night-ghost/open-headtracker/(list of files, drawings)

Other design files:
board/DIY headtracker layout.lay
board/DIY headtracker layout.lay6
