night-ghost/open-headtracker/Source Code/DIY_Headtracker_Firmware_orig/DIY_headtracker/DIY_headtracker.ino

//-----------------------------------------------------------------------------
// Original project by Dennis Frie - 2012 - Dennis.frie@gmail.com
// Discussion: http://www.rcgroups.com/forums/showthread.php?t=1677559
//
// Other contributors to this code:
//  Mark Mansur (Mangus on rcgroups)
//  
// Version history:
// - 0.01 - 0.08 - Dennis Frie - preliminary releases
// - 1.01 - April 2013 - Mark Mansur - code clean-up and refactoring, comments
//      added. Added pause functionality, added settings retrieval commands.
//      Minor optimizations.
//-----------------------------------------------------------------------------

#include <Wire.h>
#include "config.h"
#include "functions.h"
#include "sensors.h"
#include <EEPROM.h>

#include <SingleSerial.h>
SingleSerialPort(Serial);
/*
Channel mapping/config for PPM out:

1 = PPM CHANNEL 1
2 = PPM CHANNEL 2
3 = PPM CHANNEL 3
4 = PPM CHANNEL 4
5 = PPM CHANNEL 5
6 = PPM CHANNEL 6
7 = PPM CHANNEL 7
8 = PPM CHANNEL 8
9 = PPM CHANNEL 9
10 = PPM CHANNEL 10
11 = PPM CHANNEL 11
12 = PPM CHANNEL 12

Mapping example:
$123456789111CH
*/


// Local file variables
//
int frameNumber = 0;		    // Frame count since last debug serial output

char serial_data[101];          // Array for serial-data 
byte serial_index = 0; // How many bytes have been received?
char string_started = 0;        // Only saves data if string starts with right byte
byte channel_mapping[14];

char outputMag = 0;             // Stream magnetometer data to host
char outputAcc = 0;             // Stream accelerometer data to host
char outputMagAcc = 0;          // Stream mag and accell data (for calibration on PC)
char outputTrack = 0;	        // Stream angle data to host

// Keep track of button press
char lastButtonState = 0;           // 0 is not pressed, 1 is pressed
unsigned long buttonDownTime = 0;   // the system time of the press
char pauseToggled = 0;              // Used to make sure we toggle pause only once per hold
char ht_paused = 0;

// External variables (defined in other files)
//
extern unsigned char PpmIn_PpmOut[13];
extern char read_sensors;
extern char resetValues;   
extern char tiltInverse;
extern char rollInverse;
extern char panInverse;

// Settings (Defined in sensors.cpp)
//
extern float tiltRollBeta;
extern float panBeta;
extern float gyroWeightTiltRoll;
extern float GyroWeightPan;
extern int servoPanCenter;
extern int servoTiltCenter;
extern int servoRollCenter;
extern int panMaxPulse;
extern int panMinPulse;
extern int tiltMaxPulse;
extern int tiltMinPulse;
extern int rollMaxPulse;
extern int rollMinPulse;
extern float panFactor;
extern float tiltFactor;  
extern float rollFactor;
extern unsigned char servoReverseMask;
extern unsigned char htChannels[];
extern float gyroOff[];
extern float magOffset[];
extern int accOffset[]; 
// End settings   

//--------------------------------------------------------------------------------------
// Func: setup
// Desc: Called by Arduino framework at initialization time. This sets up pins for I/O,
//       initializes sensors, etc.
//--------------------------------------------------------------------------------------
void setup()
{
    Serial.begin(SERIAL_BAUD);

  
    pinMode(9,OUTPUT);
    digitalWrite(2,HIGH);
    digitalWrite(3,HIGH);  
  
    // Set all other pins to input, for safety.
    pinMode(0,INPUT);
    pinMode(1,INPUT);
    pinMode(2,INPUT);
    pinMode(3,INPUT);
    pinMode(6,INPUT);
    pinMode(7,INPUT);  
    pinMode(8,INPUT);    

    // Set button pin to input:
    pinMode(BUTTON_INPUT,INPUT);
  
    // Set internal pull-up resistor. 
    digitalWrite(BUTTON_INPUT,HIGH);
  
    digitalWrite(0,LOW); // pull-down resistor
    digitalWrite(1,LOW);
    digitalWrite(2,HIGH);
    digitalWrite(3,HIGH);  
  
    pinMode(ARDUINO_LED,OUTPUT);    // Arduino LED
    digitalWrite(ARDUINO_LED, HIGH);
    
#if FATSHARK_HT_MODULE
    pinMode(BUZZER,OUTPUT);         // Buzzer
    digitalWrite(BUZZER, HIGH);
#endif

    // Give it time to be noticed, then turn it off
    delay(200); // Note: only use delay here. This won't work when Timer0 is repurposed later.
    digitalWrite(ARDUINO_LED, LOW);

#if FATSHARK_HT_MODULE
    digitalWrite(BUZZER, LOW);
#endif

    InitPWMInterrupt();         // Start PWM interrupt  
    Wire.begin();               // Start I2C

    // If the device have just been programmed, write initial config/values to EEPROM:
    if (EEPROM.read(0) != 8)
    {
//#if (DEBUG)
        Serial.println("New board - saving default values!");
//#endif    
    
        InitSensors();
#if (ALWAYS_CAL_GYRO)    
        SetGyroOffset();
#endif     

        SaveSettings();
        SaveMagData();
        SaveAccelData();
    }
 
    GetSettings();                 // Get settings saved in EEPROM
    InitSensors();                // Initialize I2C sensors
    CalibrateMag();
    ResetCenter();
    InitTimerInterrupt();        // Start timer interrupt (for sensors)  
}

//--------------------------------------------------------------------------------------
// Func: loop
// Desc: Called by the Arduino framework once per frame. Represents main program loop.
//--------------------------------------------------------------------------------------
void loop()
{  
    // Check input button for reset/pause request
    char buttonPressed = (digitalRead(BUTTON_INPUT) == 0);

    if ( buttonPressed && lastButtonState == 0)
    {
        resetValues = 1; 
        buttonDownTime = 0;
        lastButtonState = 1;
    }
    
    if ( buttonPressed )
    {
        if ( !pauseToggled && (buttonDownTime > BUTTON_HOLD_PAUSE_THRESH) )
        {
            // Pause/unpause
            ht_paused = !ht_paused;
            resetValues = 1;
            pauseToggled = 1;
        }
    }
    else
    {
        pauseToggled = 0;
        lastButtonState = 0;
    }
    
    // All this is used for communication with GUI 
    //
    if (Serial.available())
    {
        if (string_started == 1)
        {
            // Read incoming byte
            serial_data[serial_index++] = Serial.read();
           
            // If string ends with "CH" it's channel configuration, that have been received.
            // String must always be 12 chars/bytes and ending with CH to be valid. 
            if (serial_index == 14 &&
                serial_data[serial_index-2] == 'C' &&
                serial_data[serial_index-1] == 'H' )
            {
                // To keep it simple, we will not let the channels be 0-initialized, but
                // start from 1 to match actual channels. 
                for (unsigned char i = 0; i < 13; i++)  {
                    channel_mapping[i + 1] = serial_data[i] - 48;
                  
                    // Update the dedicated PPM-in -> PPM-out array for faster performance.
                    if ((serial_data[i] - 48) < 14) {
                        PpmIn_PpmOut[serial_data[i]-48] = i + 1;
                    }
                }
               
                Serial.println("Channel mapping received");
               
               // Reset serial_index and serial_started
               serial_index = 0;
               string_started = 0;
            }
            
            // Configure headtracker
            else if (serial_data[serial_index-2] == 'H' &&
                     serial_data[serial_index-1] == 'E')
            {
                // HT parameters are passed in from the PC in this order:
                //
                // 0 tiltRollBeta      
                // 1 panBeta       
                // 2 gyroWeightTiltRoll    
                // 3 GyroWeightPan 
                // 4 tiltFactor        
                // 5 panFactor          
                // 6 rollFactor
                // 7 servoReverseMask
                // 8 servoPanCenter
                // 9 panMinPulse 
                // 10 panMaxPulse
                // 11 servoTiltCenter
                // 12 tiltMinPulse
                // 13 tiltMaxPulse
                // 14 servoRollCenter
                // 15 rollMinPulse
                // 16 rollMaxPulse
                // 17 htChannels[0]  // pan            
                // 18 htChannels[1]  // tilt 
                // 19 htChannels[2]  // roll         
             
                // Parameters from the PC client need to be scaled to match our local
                // expectations

                Serial.println("HT config received:");
           
                int valuesReceived[20] = {0,0,0,0,0,0,0,0,0,0,0,0,0,0,0,0,0,0,0,0};
                int comma_index = 0;

                for (unsigned char k = 0; k < serial_index - 2; k++)
                {
                    // Looking for comma
                    if (serial_data[k] == 44)
                    {
                        comma_index++;
                    }
                    else
                    {
                        valuesReceived[comma_index] = valuesReceived[comma_index] * 10 + (serial_data[k] - 48);
                    }
             
#if (DEBUG)
                    Serial.print(serial_data[k]);
#endif
                }

#if (DEBUG)
                Serial.println();
                for (unsigned char k = 0; k < comma_index+1; k++)
                {
                    Serial.print(valuesReceived[k]); 
                    Serial.print(",");           
                }
                Serial.println();
#endif

                tiltRollBeta  = (float)valuesReceived[0] / 100;  
                panBeta       = (float)valuesReceived[1] / 100;
                gyroWeightTiltRoll = (float)valuesReceived[2] / 100;
                GyroWeightPan = (float)valuesReceived[3] / 100;
                tiltFactor    = (float)valuesReceived[4] / 10;         
                panFactor     = (float)valuesReceived[5] / 10;          
                rollFactor    = (float)valuesReceived[6] / 10;   

                servoReverseMask = (unsigned char)valuesReceived[7];

                tiltInverse = 1;
                rollInverse = 1;
                panInverse = 1;           
                
                if ((servoReverseMask & HT_PAN_REVERSE_BIT) != 0)
                {
                    panInverse = -1;
                }
                if ((servoReverseMask & HT_ROLL_REVERSE_BIT) != 0)
                {
                    rollInverse = -1; 
                }
                if ((servoReverseMask & HT_TILT_REVERSE_BIT) != 0)
                {
                    tiltInverse = -1;
                }

                servoPanCenter = valuesReceived[8];
                panMinPulse = valuesReceived[9];
                panMaxPulse = valuesReceived[10];         
         
                servoTiltCenter = valuesReceived[11];
                tiltMinPulse = valuesReceived[12];
                tiltMaxPulse = valuesReceived[13];         

                servoRollCenter = valuesReceived[14];
                rollMinPulse = valuesReceived[15];
                rollMaxPulse = valuesReceived[16];              
     
                htChannels[0] = valuesReceived[17];                   
                htChannels[1] = valuesReceived[18];              
                htChannels[2] = valuesReceived[19];                       

                Serial.println(htChannels[0]);
                Serial.println(htChannels[1]);
                Serial.println(htChannels[2]);                
        
                SaveSettings();

                serial_index = 0;
                string_started = 0;
            } // end configure headtracker
          
            // Debug info
            else if (serial_data[serial_index-5] == 'D' &&
                     serial_data[serial_index-4] == 'E' &&
                     serial_data[serial_index-3] == 'B' &&
                     serial_data[serial_index-2] == 'U' &&
                     serial_data[serial_index-1] == 'G')
            {  
                DebugOutput();
                serial_index = 0;
                string_started = 0; 
            }

            // Firmware version requested
            else if (serial_data[serial_index-4] == 'V' &&
                     serial_data[serial_index-3] == 'E' &&
                     serial_data[serial_index-2] == 'R' &&
                     serial_data[serial_index-1] == 'S')
            {
                Serial.print("FW: ");
                Serial.println(FIRMWARE_VERSION_FLOAT, 2);
                serial_index = 0;
                string_started = 0; 
            }
          
            // Start mag and accel data stream
            else if (serial_data[serial_index-4] == 'C' &&
                     serial_data[serial_index-3] == 'M' &&
                     serial_data[serial_index-2] == 'A' &&
                     serial_data[serial_index-1] == 'S')
            {  
                outputMagAcc = 1;
                outputMag = 0;
                outputAcc = 0;
                outputTrack = 0;
                serial_index = 0;
                string_started = 0;
            }        

            // Stop mag and accel data stream
            else if (serial_data[serial_index-4] == 'C' &&
                     serial_data[serial_index-3] == 'M' &&
                     serial_data[serial_index-2] == 'A' &&
                     serial_data[serial_index-1] == 'E')
            {  
                outputMagAcc = 0;
                outputMag = 0;
                outputTrack = 0;
                outputAcc = 0;
                serial_index = 0;
                string_started = 0;
            }        

            // Start magnetometer data stream
            else if (serial_data[serial_index-4] == 'C' &&
                     serial_data[serial_index-3] == 'A' &&
                     serial_data[serial_index-2] == 'S' &&
                     serial_data[serial_index-1] == 'T')
            {  
                outputMag = 1;
                outputMagAcc = 0;
                outputAcc = 0;
                outputTrack = 0;
                serial_index = 0;
                string_started = 0; 

            }        
          
            // Stop magnetometer data stream
            else if (serial_data[serial_index-4] == 'C' &&
                     serial_data[serial_index-3] == 'A' &&
                     serial_data[serial_index-2] == 'E' &&
                     serial_data[serial_index-1] == 'N')
            {  
                outputMag = 0;
                outputMagAcc = 0;
                outputAcc = 0;
                outputTrack = 0;
                serial_index = 0;
                string_started = 0; 
            }

            // Start accelerometer data stream
            else if (serial_data[serial_index-4] == 'G' &&
                     serial_data[serial_index-3] == 'R' &&
                     serial_data[serial_index-2] == 'A' &&
                     serial_data[serial_index-1] == 'V')
            {  
                outputAcc = 1;     
                outputMagAcc = 0;
                outputMag = 0;
                outputTrack = 0;
                serial_index = 0;
                string_started = 0; 
            }              
          
            // Stop accelerometer data stream
            else if (serial_data[serial_index-4] == 'G' &&
                     serial_data[serial_index-3] == 'R' &&
                     serial_data[serial_index-2] == 'E' &&
                     serial_data[serial_index-1] == 'N')
            {  
                outputAcc = 0;
                outputMag = 0;
                outputMagAcc = 0;
                outputTrack = 0;
                serial_index = 0;
                string_started = 0; 
            }

            // Start tracking data stream
            else if (serial_data[serial_index-4] == 'P' &&
                     serial_data[serial_index-3] == 'L' &&
                     serial_data[serial_index-2] == 'S' &&
                     serial_data[serial_index-1] == 'T')
            {  
                outputTrack = 1;
                outputMagAcc = 0;
                outputMag = 0;
                outputAcc = 0;
                serial_index = 0;
                string_started = 0; 
            }        

            // Stop tracking data stream          
            else if (serial_data[serial_index-4] == 'P' &&
                     serial_data[serial_index-3] == 'L' &&
                     serial_data[serial_index-2] == 'E' &&
                     serial_data[serial_index-1] == 'N')
            {  
                outputTrack = 0;
                outputMag = 0;
                outputAcc = 0;
                outputMagAcc = 0;
                serial_index = 0;
                string_started = 0; 
            }
          
            // Save RAM settings to EEPROM
            else if (serial_data[serial_index-4] == 'S' &&
                     serial_data[serial_index-3] == 'A' &&
                     serial_data[serial_index-2] == 'V' &&
                     serial_data[serial_index-1] == 'E')
            {  
                SaveSettings();     
                serial_index = 0;
                string_started = 0; 
            }          
          
            // Calibrate gyro
            else if (serial_data[serial_index-4] == 'C' &&
                     serial_data[serial_index-3] == 'A' &&
                     serial_data[serial_index-2] == 'L' &&
                     serial_data[serial_index-1] == 'G')
            { 
                SetGyroOffset();
                SaveSettings();
               
                Serial.print("Gyro offset measured:");
                Serial.print(gyroOff[0]);
                Serial.print(",");   
                Serial.print(gyroOff[1]);
                Serial.print(",");      
                Serial.println(gyroOff[2]);    
               
                serial_index = 0;
                string_started = 0; 
            }

            // Store magnetometer offset
            else if (serial_data[serial_index-3] == 'M' &&
                     serial_data[serial_index-2] == 'A' &&
                     serial_data[serial_index-1] == 'G')
            {
                Serial.println(serial_data);
                int valuesReceived[5] = {0,0,0,0,0};
                int comma_index = 0; 
              
                for (unsigned char k = 0; k < serial_index - 3; k++)
                {
                    // Looking for comma
                    if (serial_data[k] == 44)
                    {
                        comma_index++;
                    }
                    else
                    {
                        valuesReceived[comma_index] = valuesReceived[comma_index] * 10 + (serial_data[k] - 48);
                    }
                }
                
                // Y and Z are swapped on purpose.
                magOffset[0] = valuesReceived[0] - 2000;
                magOffset[1] = valuesReceived[2] - 2000;
                magOffset[2] = valuesReceived[1] - 2000;

                serial_index = 0;
                string_started = 0; 

                SaveMagData();                
            }

            // Store accelerometer offset
            else if (serial_data[serial_index-3] == 'A' &&
                     serial_data[serial_index-2] == 'C' &&
                     serial_data[serial_index-1] == 'C')
            {
                Serial.println(serial_data);
                int valuesReceived[5] = {0,0,0,0,0};
                int comma_index = 0; 
                for (unsigned char k = 0; k < serial_index - 3; k++)
                {
                    // Looking for comma
                    if (serial_data[k] == 44)
                    {
                        comma_index++;
                    }
                    else
                    {
                        valuesReceived[comma_index] = valuesReceived[comma_index] * 10 + (serial_data[k] - 48);
                    }              
                }

                accOffset[0] = valuesReceived[0] - 2000;
                accOffset[1] = valuesReceived[1] - 2000;
                accOffset[2] = valuesReceived[2] - 2000;
                
                serial_index = 0;
                string_started = 0; 

                SaveAccelData();                
            }

            // Retrieve settings
            else if (serial_data[serial_index-4] == 'G' &&
                     serial_data[serial_index-3] == 'S' &&
                     serial_data[serial_index-2] == 'E' &&
                     serial_data[serial_index-1] == 'T' )
            {
                // Get Settings. Scale our local values to
                // real-world values usable on the PC side.
                //
                Serial.print("$SET$"); // something recognizable in the stream

                Serial.print(tiltRollBeta * 100);
                Serial.print(",");   
                Serial.print(panBeta * 100);
                Serial.print(",");
                Serial.print(gyroWeightTiltRoll * 100);  
                Serial.print(",");
                Serial.print(GyroWeightPan * 100);
                Serial.print(",");
                Serial.print(tiltFactor * 10);
                Serial.print(",");
                Serial.print(panFactor * 10);
                Serial.print(",");
                Serial.print(rollFactor * 10);
                Serial.print(",");
                Serial.print(servoReverseMask);
                Serial.print(",");
                Serial.print(servoPanCenter);
                Serial.print(",");
                Serial.print(panMinPulse);
                Serial.print(",");
                Serial.print(panMaxPulse);
                Serial.print(",");
                Serial.print(servoTiltCenter);
                Serial.print(",");
                Serial.print(tiltMinPulse);
                Serial.print(",");
                Serial.print(tiltMaxPulse);
                Serial.print(",");
                Serial.print(servoRollCenter);
                Serial.print(",");
                Serial.print(rollMinPulse);
                Serial.print(",");
                Serial.print(rollMaxPulse);
                Serial.print(",");
                Serial.print(htChannels[0]);
                Serial.print(",");
                Serial.print(htChannels[1]);
                Serial.print(",");
                Serial.println(htChannels[2]);

                Serial.println("Settings Retrieved!");

                serial_index = 0;
                string_started = 0;
            }
            else if (serial_index > 100)
            {
                // If more than 100 bytes have been received, the string is not valid.
                // Reset and "try again" (wait for $ to indicate start of new string). 
                serial_index = 0;
                string_started = 0;
            }
        }
        else if (Serial.read() == '$')
        {
            string_started = 1;
        }
    } // serial port input

    // if "read_sensors" flag is set high, read sensors and update
    if (read_sensors == 1 && ht_paused == 0)
    {
        UpdateSensors();
        GyroCalc();
        AccelCalc();
        MagCalc();
        FilterSensorData();    
               
        // Only output this data every X frames.
        if (frameNumber++ >= SERIAL_OUTPUT_FRAME_INTERVAL)
        {
            if (outputTrack == 1)
            {
                trackerOutput();
            }
            else if (outputMagAcc == 1)
            {
                calMagAccOutput();
            }
            else if (outputMag == 1)
            {
                calMagOutput(); 
            }
            else if (outputAcc == 1)
            {
                calAccOutput();
            }
            frameNumber = 0; 
        }

        // Will first update read_sensors when everything is done.  
        read_sensors = 0;
    }
}

//--------------------------------------------------------------------------------------
// Func: SaveSettings
// Desc: Saves device settings to EEPROM for retrieval at boot-up.
//--------------------------------------------------------------------------------------
void SaveSettings()
{  
    EEPROM.write(1, (unsigned char)(tiltRollBeta * 100));
    EEPROM.write(2, (unsigned char)(panBeta * 100));
    EEPROM.write(3, (unsigned char)(gyroWeightTiltRoll * 100));
    EEPROM.write(4, (unsigned char)(GyroWeightPan * 100));
  
    EEPROM.write(5, (unsigned char)servoReverseMask);
    
    // 6 unused
  
    EEPROM.write(7, (unsigned char)servoPanCenter);
    EEPROM.write(8, (unsigned char)(servoPanCenter >> 8));  
  
    EEPROM.write(9, (unsigned char)(tiltFactor * 10));
    EEPROM.write(10, (int)((tiltFactor * 10)) >> 8);  

    EEPROM.write(11, (unsigned char) (panFactor * 10));
    EEPROM.write(12, (int)((panFactor * 10)) >> 8);  

    EEPROM.write(13, (unsigned char) (rollFactor * 10));
    EEPROM.write(14, (int)((rollFactor * 10)) >> 8);  

    // 15 unused

    EEPROM.write(16, (unsigned char)servoTiltCenter);
    EEPROM.write(17, (unsigned char)(servoTiltCenter >> 8));  

    EEPROM.write(18, (unsigned char)servoRollCenter);
    EEPROM.write(19, (unsigned char)(servoRollCenter >> 8));  


    EEPROM.write(20, (unsigned char)panMaxPulse);
    EEPROM.write(21, (unsigned char)(panMaxPulse >> 8));  
  
    EEPROM.write(22, (unsigned char)panMinPulse);
    EEPROM.write(23, (unsigned char)(panMinPulse >> 8));    

    EEPROM.write(24, (unsigned char)tiltMaxPulse);
    EEPROM.write(25, (unsigned char)(tiltMaxPulse >> 8));    

    EEPROM.write(26, (unsigned char)tiltMinPulse);
    EEPROM.write(27, (unsigned char)(tiltMinPulse >> 8));

    EEPROM.write(28, (unsigned char)rollMaxPulse);
    EEPROM.write(29, (unsigned char)(rollMaxPulse >> 8));    

    EEPROM.write(30, (unsigned char)rollMinPulse);
    EEPROM.write(31, (unsigned char)(rollMinPulse >> 8)); 
  
    EEPROM.write(32, (unsigned char)htChannels[0]);
    EEPROM.write(33, (unsigned char)htChannels[1]);
    EEPROM.write(34, (unsigned char)htChannels[2]);
  
    // Saving gyro calibration values
    int temp = (int)(gyroOff[0] + 500.5);
    EEPROM.write(35, (unsigned char)temp);
    EEPROM.write(36, (unsigned char)(temp >> 8));   
  
    temp = (int)(gyroOff[1] + 500.5);
    EEPROM.write(37, (unsigned char)temp);
    EEPROM.write(38, (unsigned char)(temp >> 8));     

    temp = (int)(gyroOff[2] + 500.5);
    EEPROM.write(39, (unsigned char)temp);
    EEPROM.write(40, (unsigned char)(temp >> 8));    
  
    // Mark the memory to indicate that it has been
    // written. Used to determine if board is newly flashed
    // or not.
    EEPROM.write(0,8); 

    Serial.println("Settings saved!");
}

//--------------------------------------------------------------------------------------
// Func: GetSettings
// Desc: Retrieves device settings from EEPROM.
//--------------------------------------------------------------------------------------
void GetSettings()
{  
    tiltRollBeta    = (float)EEPROM.read(1) / 100;
    panBeta         = (float)EEPROM.read(2) / 100;
    gyroWeightTiltRoll = (float)EEPROM.read(3) / 100;
    GyroWeightPan   = (float)EEPROM.read(4) / 100;  
  
    tiltInverse = 1;
    rollInverse = 1;
    panInverse = 1;

    unsigned char temp = EEPROM.read(5);
    if ( temp & HT_TILT_REVERSE_BIT )
    {
        tiltInverse = -1;
    }  
    if ( temp & HT_ROLL_REVERSE_BIT )
    {
        rollInverse = -1;
    }
    if ( temp & HT_PAN_REVERSE_BIT )
    {
        panInverse = -1;
    }

    // 6 unused

    servoPanCenter  = EEPROM.read(7) + (EEPROM.read(8) << 8);
    tiltFactor      = (float)(EEPROM.read(9) + (EEPROM.read(10) << 8)) / 10;
    panFactor       = (float)(EEPROM.read(11) + (EEPROM.read(12) << 8)) / 10;
    rollFactor       = (float)(EEPROM.read(13) + (EEPROM.read(14) << 8)) / 10;  

    // 15 unused

    servoTiltCenter = EEPROM.read(16) + (EEPROM.read(17) << 8);
    servoRollCenter = EEPROM.read(18) + (EEPROM.read(19) << 8);  
  
    panMaxPulse   = EEPROM.read(20) + (EEPROM.read(21) << 8);  
    panMinPulse   = EEPROM.read(22) + (EEPROM.read(23) << 8);    
  
    tiltMaxPulse  = EEPROM.read(24) + (EEPROM.read(25) << 8);  
    tiltMinPulse  = EEPROM.read(26) + (EEPROM.read(27) << 8);      
  
    rollMaxPulse  = EEPROM.read(28) + (EEPROM.read(29) << 8);  
    rollMinPulse  = EEPROM.read(30) + (EEPROM.read(31) << 8);        
  
    htChannels[0] = EEPROM.read(32);  
    htChannels[1] = EEPROM.read(33);  
    htChannels[2] = EEPROM.read(34);    
  
    gyroOff[0] = EEPROM.read(35) + (EEPROM.read(36) << 8) - 500; 
    gyroOff[1] = EEPROM.read(37) + (EEPROM.read(38) << 8) - 500; 
    gyroOff[2] = EEPROM.read(39) + (EEPROM.read(40) << 8) - 500;   
  
    magOffset[0] = EEPROM.read(200) + (EEPROM.read(201) << 8) - 2000;     
    magOffset[1] = EEPROM.read(202) + (EEPROM.read(203) << 8) - 2000;     
    magOffset[2] = EEPROM.read(204) + (EEPROM.read(205) << 8) - 2000;       
  
    accOffset[0] = EEPROM.read(206) + (EEPROM.read(207) << 8) - 2000;     
    accOffset[1] = EEPROM.read(208) + (EEPROM.read(209) << 8) - 2000;     
    accOffset[2] = EEPROM.read(210) + (EEPROM.read(211) << 8) - 2000;       
  
 
#if (DEBUG)
    DebugOutput();
#endif
}

//--------------------------------------------------------------------------------------
// Func: SaveMagData
// Desc: Stores magnetometer calibration info to EEPROM.
//--------------------------------------------------------------------------------------
void SaveMagData()
{
    int temp = (int)(magOffset[0] + 2000);
    EEPROM.write(200, (unsigned char)temp);
    EEPROM.write(201, (unsigned char)(temp >> 8));   
  
    temp = (int)(magOffset[1] + 2000);
    EEPROM.write(202, (unsigned char)temp);
    EEPROM.write(203, (unsigned char)(temp >> 8));   
  
    temp = (int)(magOffset[2] + 2000);
    EEPROM.write(204, (unsigned char)temp);
    EEPROM.write(205, (unsigned char)(temp >> 8));   
  
    Serial.println("Mag offset saved!"); 
    Serial.print(magOffset[0]);
    Serial.print(", "); 
    Serial.print(magOffset[1]);
    Serial.print(", ");   
    Serial.println(magOffset[2]); 
}

//--------------------------------------------------------------------------------------
// Func: SaveAccelData
// Desc: Stores accelerometer calibration data to EEPOM.
//--------------------------------------------------------------------------------------
void SaveAccelData()
{
    int temp = (int)(accOffset[0] + 2000);
    EEPROM.write(206, (unsigned char)temp);
    EEPROM.write(207, (unsigned char)(temp >> 8));   
  
    temp = (int)(accOffset[1] + 2000);
    EEPROM.write(208, (unsigned char)temp);
    EEPROM.write(209, (unsigned char)(temp >> 8));   
  
    temp = (int)(accOffset[2] + 2000);
    EEPROM.write(210, (unsigned char)temp);
    EEPROM.write(211, (unsigned char)(temp >> 8));   
  
    Serial.println("Acc offset saved!"); 
    Serial.print(accOffset[0]);
    Serial.print(","); 
    Serial.print(accOffset[1]);
    Serial.print(",");   
    Serial.println(accOffset[2]);  
}

//--------------------------------------------------------------------------------------
// Func: DebugOutput
// Desc: Outputs useful device/debug information to the serial port.
//--------------------------------------------------------------------------------------
void DebugOutput()
{
    Serial.println();  
    Serial.println();
    Serial.println();
    Serial.println("------ Debug info------");

    Serial.print("FW Version: ");
    Serial.println(FIRMWARE_VERSION_FLOAT, 2);
    
    Serial.print("tiltRollBeta: ");
    Serial.println(tiltRollBeta); 

    Serial.print("panBeta: ");
    Serial.println(panBeta); 
 
    Serial.print("gyroWeightTiltRoll: ");
    Serial.println(gyroWeightTiltRoll); 

    Serial.print("GyroWeightPan: ");
    Serial.println(GyroWeightPan); 

    Serial.print("servoPanCenter: ");
    Serial.println(servoPanCenter); 
 
    Serial.print("servoTiltCenter: ");
    Serial.println(servoTiltCenter); 

    Serial.print("servoRollCenter: ");
    Serial.println(servoRollCenter); 

    Serial.print("tiltFactor: ");
    Serial.println(tiltFactor); 

    Serial.print("panFactor: ");
    Serial.println(panFactor);  
 
    Serial.print("Gyro offset stored ");
    Serial.print(gyroOff[0]);
    Serial.print(",");   
    Serial.print(gyroOff[1]);
    Serial.print(",");      
    Serial.println(gyroOff[2]);    
 
    Serial.print("Mag offset stored ");
    Serial.print(magOffset[0]);
    Serial.print(",");   
    Serial.print(magOffset[1]);
    Serial.print(",");      
    Serial.println(magOffset[2]);
 
    Serial.print("Acc offset stored ");
    Serial.print(accOffset[0]);
    Serial.print(",");   
    Serial.print(accOffset[1]);
    Serial.print(",");      
    Serial.println(accOffset[2]);
 
    SensorInfoPrint();    
}
