night-ghost/open-headtracker/Source Code/DIY_headtracker_GY86/DIY_headtracker/mpu6050dmp6.cpp

/*
MPU6050 lib 0x02

copyright (c) Davide Gironi, 2012

Released under GPLv3.
Please refer to LICENSE file for licensing information.
*/

/*
 * This file contains all the functions needed to process 6-axis orientation by the internal chip processor
 */

//to enable get roll, pitch and yaw function we include the math function
//if some error appears we must add -lm and -lc to C linker, the linker line should become somethink like this
//${COMMAND} -lm ${FLAGS} ${OUTPUT_FLAG} ${OUTPUT_PREFIX}${OUTPUT} ${INPUTS} -lc


#include "mpu6050.h"

#if MPU6050_GETATTITUDE == 2

#include <avr/io.h>
#include <avr/pgmspace.h>
#include <avr/interrupt.h>
#include <util/delay.h>
#include <math.h>  //include libm

#define MPU6050_DMP_CODE_SIZE 1929
#define MPU6050_DMP_CONFIG_SIZE 192
#define MPU6050_DMP_UPDATES_SIZE 47

volatile uint8_t mpu6050_mpuInterrupt = 0;
uint8_t *dmpPacketBuffer;
uint16_t mpu6050_fifoCount = 0;
uint8_t mpu6050_mpuIntStatus = 0;
uint8_t mpu6050_fifoBuffer[64];


/* ================================================================================================ *
 | Default MotionApps v2.0 42-byte FIFO packet structure:                                           |
 |                                                                                                  |
 | [QUAT W][      ][QUAT X][      ][QUAT Y][      ][QUAT Z][      ][GYRO X][      ][GYRO Y][      ] |
 |   0   1   2   3   4   5   6   7   8   9  10  11  12  13  14  15  16  17  18  19  20  21  22  23  |
 |                                                                                                  |
 | [GYRO Z][      ][ACC X ][      ][ACC Y ][      ][ACC Z ][      ][      ]                         |
 |  24  25  26  27  28  29  30  31  32  33  34  35  36  37  38  39  40  41                          |
 * ================================================================================================ */

// this block of memory gets written to the MPU on start-up, and it seems
// to be volatile memory, so it has to be done each time (it only takes ~1
// second though)
const prog_uchar mpu6050_dmpMemory[MPU6050_DMP_CODE_SIZE] PROGMEM = {
    // bank 0, 256 bytes
    0xFB, 0x00, 0x00, 0x3E, 0x00, 0x0B, 0x00, 0x36, 0x00, 0x01, 0x00, 0x02, 0x00, 0x03, 0x00, 0x00,
    0x00, 0x65, 0x00, 0x54, 0xFF, 0xEF, 0x00, 0x00, 0xFA, 0x80, 0x00, 0x0B, 0x12, 0x82, 0x00, 0x01,
    0x00, 0x02, 0x00, 0x00, 0x00, 0x00, 0x00, 0x00, 0x00, 0x00, 0x00, 0x00, 0x00, 0x00, 0x00, 0x00,
    0x00, 0x28, 0x00, 0x00, 0xFF, 0xFF, 0x45, 0x81, 0xFF, 0xFF, 0xFA, 0x72, 0x00, 0x00, 0x00, 0x00,
    0x00, 0x00, 0x03, 0xE8, 0x00, 0x00, 0x00, 0x01, 0x00, 0x01, 0x7F, 0xFF, 0xFF, 0xFE, 0x80, 0x01,
    0x00, 0x1B, 0x00, 0x00, 0x00, 0x00, 0x00, 0x00, 0x00, 0x00, 0x00, 0x00, 0x00, 0x00, 0x00, 0x00,
    0x00, 0x3E, 0x03, 0x30, 0x40, 0x00, 0x00, 0x00, 0x02, 0xCA, 0xE3, 0x09, 0x3E, 0x80, 0x00, 0x00,
    0x20, 0x00, 0x00, 0x00, 0x00, 0x00, 0x00, 0x00, 0x40, 0x00, 0x00, 0x00, 0x60, 0x00, 0x00, 0x00,
    0x41, 0xFF, 0x00, 0x00, 0x00, 0x00, 0x0B, 0x2A, 0x00, 0x00, 0x16, 0x55, 0x00, 0x00, 0x21, 0x82,
    0xFD, 0x87, 0x26, 0x50, 0xFD, 0x80, 0x00, 0x00, 0x00, 0x1F, 0x00, 0x00, 0x00, 0x05, 0x80, 0x00,
    0x00, 0x00, 0x00, 0x00, 0x00, 0x01, 0x00, 0x00, 0x00, 0x02, 0x00, 0x00, 0x00, 0x03, 0x00, 0x00,
    0x40, 0x00, 0x00, 0x00, 0x00, 0x00, 0x04, 0x6F, 0x00, 0x02, 0x65, 0x32, 0x00, 0x00, 0x5E, 0xC0,
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
    0xA3, 0xB2, 0xA3, 0xA3, 0xA3, 0xA3, 0xA3, 0xA3, 0xB0, 0x87, 0xB5, 0x99, 0xF1, 0xA3, 0xA3, 0xA3,
    0x98, 0xF1, 0xA3, 0xA3, 0xA3, 0xA3, 0x97, 0xA3, 0xA3, 0xA3, 0xA3, 0xF3, 0x9B, 0xA3, 0xA3, 0xDC,
    0xB9, 0xA7, 0xF1, 0x26, 0x26, 0x26, 0xD8, 0xD8, 0xFF
};

const prog_uchar mpu6050_dmpConfig[MPU6050_DMP_CONFIG_SIZE] PROGMEM = {
//  BANK    OFFSET  LENGTH  [DATA]
    0x03,   0x7B,   0x03,   0x4C, 0xCD, 0x6C,         // FCFG_1 inv_set_gyro_calibration
    0x03,   0xAB,   0x03,   0x36, 0x56, 0x76,         // FCFG_3 inv_set_gyro_calibration
    0x00,   0x68,   0x04,   0x02, 0xCB, 0x47, 0xA2,   // D_0_104 inv_set_gyro_calibration
    0x02,   0x18,   0x04,   0x00, 0x05, 0x8B, 0xC1,   // D_0_24 inv_set_gyro_calibration
    0x01,   0x0C,   0x04,   0x00, 0x00, 0x00, 0x00,   // D_1_152 inv_set_accel_calibration
    0x03,   0x7F,   0x06,   0x0C, 0xC9, 0x2C, 0x97, 0x97, 0x97, // FCFG_2 inv_set_accel_calibration
    0x03,   0x89,   0x03,   0x26, 0x46, 0x66,         // FCFG_7 inv_set_accel_calibration
    0x00,   0x6C,   0x02,   0x20, 0x00,               // D_0_108 inv_set_accel_calibration
    0x02,   0x40,   0x04,   0x00, 0x00, 0x00, 0x00,   // CPASS_MTX_00 inv_set_compass_calibration
    0x02,   0x44,   0x04,   0x00, 0x00, 0x00, 0x00,   // CPASS_MTX_01
    0x02,   0x48,   0x04,   0x00, 0x00, 0x00, 0x00,   // CPASS_MTX_02
    0x02,   0x4C,   0x04,   0x00, 0x00, 0x00, 0x00,   // CPASS_MTX_10
    0x02,   0x50,   0x04,   0x00, 0x00, 0x00, 0x00,   // CPASS_MTX_11
    0x02,   0x54,   0x04,   0x00, 0x00, 0x00, 0x00,   // CPASS_MTX_12
    0x02,   0x58,   0x04,   0x00, 0x00, 0x00, 0x00,   // CPASS_MTX_20
    0x02,   0x5C,   0x04,   0x00, 0x00, 0x00, 0x00,   // CPASS_MTX_21
    0x02,   0xBC,   0x04,   0x00, 0x00, 0x00, 0x00,   // CPASS_MTX_22
    0x01,   0xEC,   0x04,   0x00, 0x00, 0x40, 0x00,   // D_1_236 inv_apply_endian_accel
    0x03,   0x7F,   0x06,   0x0C, 0xC9, 0x2C, 0x97, 0x97, 0x97, // FCFG_2 inv_set_mpu_sensors
    0x04,   0x02,   0x03,   0x0D, 0x35, 0x5D,         // CFG_MOTION_BIAS inv_turn_on_bias_from_no_motion
    0x04,   0x09,   0x04,   0x87, 0x2D, 0x35, 0x3D,   // FCFG_5 inv_set_bias_update
    0x00,   0xA3,   0x01,   0x00,                     // D_0_163 inv_set_dead_zone
                 // SPECIAL 0x01 = enable interrupts
    0x00,   0x00,   0x00,   0x01, // SET INT_ENABLE at i=22, SPECIAL INSTRUCTION
    0x07,   0x86,   0x01,   0xFE,                     // CFG_6 inv_set_fifo_interupt
    0x07,   0x41,   0x05,   0xF1, 0x20, 0x28, 0x30, 0x38, // CFG_8 inv_send_quaternion
    0x07,   0x7E,   0x01,   0x30,                     // CFG_16 inv_set_footer
    0x07,   0x46,   0x01,   0x9A,                     // CFG_GYRO_SOURCE inv_send_gyro
    0x07,   0x47,   0x04,   0xF1, 0x28, 0x30, 0x38,   // CFG_9 inv_send_gyro -> inv_construct3_fifo
    0x07,   0x6C,   0x04,   0xF1, 0x28, 0x30, 0x38,   // CFG_12 inv_send_accel -> inv_construct3_fifo
    0x02,   0x16,   0x02,   0x00, 0x09                // D_0_22 inv_set_fifo_rate

    // This very last 0x01 WAS a 0x09, which drops the FIFO rate down to 20 Hz. 0x07 is 25 Hz,
    // 0x01 is 100Hz. Going faster than 100Hz (0x00=200Hz) tends to result in very noisy data.
    // DMP output frequency is calculated easily using this equation: (200Hz / (1 + value))

    // It is important to make sure the host processor can keep up with reading and processing
    // the FIFO output at the desired rate. Handling FIFO overflow cleanly is also a good idea.
};

const prog_uchar mpu6050_dmpUpdates[MPU6050_DMP_UPDATES_SIZE] PROGMEM = {
    0x01,   0xB2,   0x02,   0xFF, 0xFF,
    0x01,   0x90,   0x04,   0x09, 0x23, 0xA1, 0x35,
    0x01,   0x6A,   0x02,   0x06, 0x00,
    0x01,   0x60,   0x08,   0x00, 0x00, 0x00, 0x00, 0x00, 0x00, 0x00, 0x00,
    0x00,   0x60,   0x04,   0x40, 0x00, 0x00, 0x00,
    0x01,   0x62,   0x02,   0x00, 0x00,
    0x00,   0x60,   0x04,   0x00, 0x40, 0x00, 0x00
};

/*
 * initialize mpu6050 dmp
 */
uint8_t mpu6050_dmpInitialize() {
	//setup interrupt
	MPU6050_DMP_INT0SETUP;

	//reset
	mpu6050_writeBit(MPU6050_RA_PWR_MGMT_1, MPU6050_PWR1_DEVICE_RESET_BIT, 1);
    _delay_ms(30);//wait after reset

    //disable sleep mode
    mpu6050_setSleepDisabled();

    //set memorybank to 0
    mpu6050_setMemoryBank(0, 0, 0);

    //get X/Y/Z gyro offsets
    int8_t xgOffset = mpu6050_getXGyroOffset();
    int8_t ygOffset = mpu6050_getYGyroOffset();
    int8_t zgOffset = mpu6050_getZGyroOffset();

    //setting slave 0 address to 0x7F
	mpu6050_writeByte(MPU6050_RA_I2C_SLV0_ADDR + 0*3, 0x7F);
	//disabling I2C Master mode
	mpu6050_writeBit(MPU6050_RA_USER_CTRL, MPU6050_USERCTRL_I2C_MST_EN_BIT, 0);
	//setting slave 0 address to 0x68 (self)
	mpu6050_writeByte(MPU6050_RA_I2C_SLV0_ADDR + 0*3, 0x68);
	//resetting I2C Master control
	mpu6050_writeBit(MPU6050_RA_USER_CTRL, MPU6050_USERCTRL_I2C_MST_RESET_BIT, 1);
	_delay_ms(20);

    //load DMP code into memory banks
    if (mpu6050_writeMemoryBlock(mpu6050_dmpMemory, MPU6050_DMP_CODE_SIZE, 0, 0, 1, 1) == 1) {
        if (mpu6050_writeDMPConfigurationSet(mpu6050_dmpConfig, MPU6050_DMP_CONFIG_SIZE, 1)) {

        	//set clock source
        	mpu6050_writeBits(MPU6050_RA_PWR_MGMT_1, MPU6050_PWR1_CLKSEL_BIT, MPU6050_PWR1_CLKSEL_LENGTH, MPU6050_CLOCK_PLL_ZGYRO);

        	//set DMP and FIFO_OFLOW interrupts enabled
        	mpu6050_writeByte(MPU6050_RA_INT_ENABLE, 0x12);

            //set sample rate
        	mpu6050_writeByte(MPU6050_RA_SMPLRT_DIV, 4); // 1khz / (1 + 4) = 200 Hz

            //set external frame sync to TEMP_OUT_L[0]
            mpu6050_writeBits(MPU6050_RA_CONFIG, MPU6050_CFG_EXT_SYNC_SET_BIT, MPU6050_CFG_EXT_SYNC_SET_LENGTH, MPU6050_EXT_SYNC_TEMP_OUT_L);

            //set DLPF bandwidth to 42Hz
            mpu6050_writeBits(MPU6050_RA_CONFIG, MPU6050_CFG_DLPF_CFG_BIT, MPU6050_CFG_DLPF_CFG_LENGTH, MPU6050_DLPF_BW_42);

            //set gyro sensitivity to +/- 2000 deg/sec
            mpu6050_writeBits(MPU6050_RA_GYRO_CONFIG, MPU6050_GCONFIG_FS_SEL_BIT, MPU6050_GCONFIG_FS_SEL_LENGTH, MPU6050_GYRO_FS_2000);

            //set DMP configuration bytes (function unknown)
            mpu6050_writeByte(MPU6050_RA_DMP_CFG_1, 0x03);
            mpu6050_writeByte(MPU6050_RA_DMP_CFG_2, 0x00);

            //clear OTP Bank flag
            mpu6050_writeBit(MPU6050_RA_XG_OFFS_TC, MPU6050_TC_OTP_BNK_VLD_BIT, 0);

            //set X/Y/Z gyro offsets to previous values
            //xgOffset = 0;
            //ygOffset = 0;
            zgOffset = 90;

            mpu6050_setXGyroOffset(xgOffset);
            mpu6050_setYGyroOffset(ygOffset);
            mpu6050_setZGyroOffset(zgOffset);

            //set X/Y/Z gyro user offsets to zero
            mpu6050_writeWords(MPU6050_RA_XG_OFFS_USRH, 1, 0);
            mpu6050_writeWords(MPU6050_RA_YG_OFFS_USRH, 1, 0);
            mpu6050_writeWords(MPU6050_RA_ZG_OFFS_USRH, 1, 0);

            //writing final memory update 1/7 (function unknown)
            uint8_t dmpUpdate[16], j;
            uint16_t pos = 0;
            for (j = 0; j < 4 || j < dmpUpdate[2] + 3; j++, pos++) dmpUpdate[j] = pgm_read_byte(&mpu6050_dmpUpdates[pos]);
            mpu6050_writeMemoryBlock(dmpUpdate + 3, dmpUpdate[2], dmpUpdate[0], dmpUpdate[1], 1, 0);

            //writing final memory update 2/7 (function unknown)
            for (j = 0; j < 4 || j < dmpUpdate[2] + 3; j++, pos++) dmpUpdate[j] = pgm_read_byte(&mpu6050_dmpUpdates[pos]);
            mpu6050_writeMemoryBlock(dmpUpdate + 3, dmpUpdate[2], dmpUpdate[0], dmpUpdate[1], 1, 0);

            //reset FIFO
            mpu6050_writeBits(MPU6050_RA_USER_CTRL, MPU6050_USERCTRL_FIFO_RESET_BIT, 1, 1);

            //reading FIFO count
            uint8_t fifoCount = mpu6050_getFIFOCount();
            uint8_t fifoBuffer[128];

            //current FIFO count
            mpu6050_readBytes(MPU6050_RA_FIFO_R_W, fifoCount, fifoBuffer);

            //setting motion detection threshold to 2
            mpu6050_writeByte(MPU6050_RA_MOT_THR, 2);

            //setting zero-motion detection threshold to 156
            mpu6050_writeByte(MPU6050_RA_ZRMOT_THR, 156);

            //setting motion detection duration to 80
            mpu6050_writeByte(MPU6050_RA_MOT_DUR, 80);

            //setting zero-motion detection duration to 0
            mpu6050_writeByte(MPU6050_RA_ZRMOT_DUR, 0);

            //reset FIFO
            mpu6050_writeBit(MPU6050_RA_USER_CTRL, MPU6050_USERCTRL_FIFO_RESET_BIT, 1);

            //enabling FIFO
            mpu6050_writeBit(MPU6050_RA_USER_CTRL, MPU6050_USERCTRL_FIFO_EN_BIT, 1);

            //enabling DMP
            mpu6050_dmpEnable();

            //resetting DMP
            mpu6050_writeBit(MPU6050_RA_USER_CTRL, MPU6050_USERCTRL_DMP_RESET_BIT, 1);

            //waiting for FIFO count > 2
            while ((fifoCount = mpu6050_getFIFOCount()) < 3);

            //writing final memory update 3/7 (function unknown)
            for (j = 0; j < 4 || j < dmpUpdate[2] + 3; j++, pos++) dmpUpdate[j] = pgm_read_byte(&mpu6050_dmpUpdates[pos]);
            mpu6050_writeMemoryBlock(dmpUpdate + 3, dmpUpdate[2], dmpUpdate[0], dmpUpdate[1], 1, 0);

            //writing final memory update 4/7 (function unknown)
            for (j = 0; j < 4 || j < dmpUpdate[2] + 3; j++, pos++) dmpUpdate[j] = pgm_read_byte(&mpu6050_dmpUpdates[pos]);
            mpu6050_writeMemoryBlock(dmpUpdate + 3, dmpUpdate[2], dmpUpdate[0], dmpUpdate[1], 1, 0);

            //writing final memory update 5/7 (function unknown)
            for (j = 0; j < 4 || j < dmpUpdate[2] + 3; j++, pos++) dmpUpdate[j] = pgm_read_byte(&mpu6050_dmpUpdates[pos]);
            mpu6050_writeMemoryBlock(dmpUpdate + 3, dmpUpdate[2], dmpUpdate[0], dmpUpdate[1], 1, 0);

            //reading FIFO data..."));
            mpu6050_getFIFOBytes(fifoBuffer, fifoCount);

            //reading final memory update 6/7 (function unknown)
            for (j = 0; j < 4 || j < dmpUpdate[2] + 3; j++, pos++) dmpUpdate[j] = pgm_read_byte(&mpu6050_dmpUpdates[pos]);
            mpu6050_readMemoryBlock(dmpUpdate + 3, dmpUpdate[2], dmpUpdate[0], dmpUpdate[1]);

            //waiting for FIFO count > 2
            while ((fifoCount = mpu6050_getFIFOCount()) < 3);

            //reading FIFO data
            mpu6050_getFIFOBytes(fifoBuffer, fifoCount);

            //writing final memory update 7/7 (function unknown)
            for (j = 0; j < 4 || j < dmpUpdate[2] + 3; j++, pos++) dmpUpdate[j] = pgm_read_byte(&mpu6050_dmpUpdates[pos]);
            mpu6050_writeMemoryBlock(dmpUpdate + 3, dmpUpdate[2], dmpUpdate[0], dmpUpdate[1], 1, 0);

            //disabling DMP (you turn it on later)
            mpu6050_dmpDisable();

            //resetting FIFO and clearing INT status one last time
            mpu6050_writeBit(MPU6050_RA_USER_CTRL, MPU6050_USERCTRL_FIFO_RESET_BIT, 1);
        } else {
            return 2; // configuration block loading failed
        }
    } else {
        return 1; // main binary block loading failed
    }
    return 0; // success
}

/*
 * enable dmp
 */
void mpu6050_dmpEnable() {
	MPU6050_DMP_INT0ENABLE;
	mpu6050_writeBit(MPU6050_RA_USER_CTRL, MPU6050_USERCTRL_DMP_EN_BIT, 1);
}

/*
 * disable dmp
 */
void mpu6050_dmpDisable() {
	MPU6050_DMP_INT0DISABLE;
	mpu6050_writeBit(MPU6050_RA_USER_CTRL, MPU6050_USERCTRL_DMP_EN_BIT, 0);
}

/*
 * get quaternion from packet
 */
void mpu6050_getQuaternion(const uint8_t* packet, double *qw, double *qx, double *qy, double *qz) {
	if (packet == 0) packet = dmpPacketBuffer;
    *qw = (double)((packet[0] << 8) + packet[1]) / 16384.0f;
    *qx = (double)((packet[4] << 8) + packet[5]) / 16384.0f;
    *qy = (double)((packet[8] << 8) + packet[9]) / 16384.0f;
    *qz = (double)((packet[12] << 8) + packet[13]) / 16384.0f;
}

/*
 * get euler angles
 * aerospace sequence, to obtain sensor attitude:
 * 1. rotate around sensor Z plane by yaw
 * 2. rotate around sensor Y plane by pitch
 * 3. rotate around sensor X plane by roll
 */
void mpu6050_getRollPitchYaw(double qw, double qx, double qy, double qz, double *roll, double *pitch, double *yaw) {
	*yaw = atan2(2*qx*qy - 2*qw*qz, 2*qw*qw + 2*qx*qx - 1);
	*pitch = -asin(2*qx*qz + 2*qw*qy);
	*roll = atan2(2*qy*qz - 2*qw*qx, 2*qw*qw + 2*qz*qz - 1);
}

/*
 * get quaternion and wait
 */
uint8_t mpu6050_getQuaternionWait(double *qw, double *qx, double *qy, double *qz) {
	while (!mpu6050_mpuInterrupt && mpu6050_fifoCount < MPU6050_DMP_dmpPacketSize);
	//reset interrupt
	mpu6050_mpuInterrupt = 0;

	//check for overflow
	mpu6050_mpuIntStatus = mpu6050_getIntStatus();
	mpu6050_fifoCount = mpu6050_getFIFOCount();
	if ((mpu6050_mpuIntStatus & 0x10) || mpu6050_fifoCount == 1024) {
		//reset
		mpu6050_resetFIFO();
	} else if (mpu6050_mpuIntStatus & 0x02) {
		//wait for correct available data length, should be a VERY short wait
		while (mpu6050_fifoCount < MPU6050_DMP_dmpPacketSize)
			mpu6050_fifoCount = mpu6050_getFIFOCount();
		//read a packet from FIFO
		mpu6050_getFIFOBytes(mpu6050_fifoBuffer, MPU6050_DMP_dmpPacketSize);
		mpu6050_fifoCount -= MPU6050_DMP_dmpPacketSize;
		//get quaternion
		mpu6050_getQuaternion(mpu6050_fifoBuffer, qw, qx, qy, qz);
		return 1;
	}

	return 0;
}

/*
 * on interrupt set data availabe
 */
ISR (INT0_vect) {
	mpu6050_mpuInterrupt = 1;
}

#endif
