night-ghost/open-headtracker/Source Code/DIY_Headtracker_Firmware_fastserial/DIY_headtracker/FourtOrderFilter.h

/*
  AeroQuad v3.0.1 - February 2012
  www.AeroQuad.com
  Copyright (c) 2012 Ted Carancho.  All rights reserved.
  An Open Source Arduino based multicopter.
 
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
  You should have received a copy of the GNU General Public License 
  along with this program. If not, see <http://www.gnu.org/licenses/>. 
*/

#ifndef _AQ_FOURTH_ORDER_FILTER_H_
#define _AQ_FOURTH_ORDER_FILTER_H_

////////////////////////////////////////////////////////////////////////////////
//
//
////////////////////////////////////////////////////////////////////////////////


struct fourthOrderData
{
  float  inputTm1,  inputTm2,  inputTm3,  inputTm4;
  float outputTm1, outputTm2, outputTm3, outputTm4;
} fourthOrder[3] = {
    {0,0,0,0, 0,0,0,0},	// X
    {0,0,0,0, 0,0,0,0}, // Y
    {-9.8065, -9.8065, -9.8065, -9.8065,  -9.8065, -9.8065, -9.8065, -9.8065 }, //Z
};

float computeFourthOrder(float currentInput, struct fourthOrderData *filterParameters)
{
  // cheby2(4,60,12.5/50)
  #define _b0  0.001893594048567
  #define _b1 -0.002220262954039
  #define _b2  0.003389066536478
  #define _b3 -0.002220262954039
  #define _b4  0.001893594048567
  
  #define _a1 -3.362256889209355
  #define _a2  4.282608240117919
  #define _a3 -2.444765517272841
  #define _a4  0.527149895089809
  
  float output;
  
  output = _b0 * currentInput                + 
           _b1 * filterParameters->inputTm1  + 
           _b2 * filterParameters->inputTm2  +
           _b3 * filterParameters->inputTm3  +
           _b4 * filterParameters->inputTm4  -
           _a1 * filterParameters->outputTm1 -
           _a2 * filterParameters->outputTm2 -
           _a3 * filterParameters->outputTm3 -
           _a4 * filterParameters->outputTm4;

  filterParameters->inputTm4 = filterParameters->inputTm3;
  filterParameters->inputTm3 = filterParameters->inputTm2;
  filterParameters->inputTm2 = filterParameters->inputTm1;
  filterParameters->inputTm1 = currentInput;
  
  filterParameters->outputTm4 = filterParameters->outputTm3;
  filterParameters->outputTm3 = filterParameters->outputTm2;
  filterParameters->outputTm2 = filterParameters->outputTm1;
  filterParameters->outputTm1 = output;
    
  return output;
}


#endif
