night-ghost/open-headtracker/Source Code/HeadTracker_GUI/MainForm.h

#pragma once
#include "CalWizard.h"
#include "HeadTrackerHardware.h"

namespace HeadTrackerGUI {

    using namespace System;
    using namespace System::ComponentModel;
    using namespace System::Collections;
    using namespace System::Windows::Forms;
    using namespace System::Data;
    using namespace System::Drawing;
	using namespace System::Diagnostics;
	using namespace System::Globalization;

    /// <summary>
    /// Summary for Form1
    /// </summary>
    public ref class Form1 : public System::Windows::Forms::Form
    {
	private:
		array<Int32>^ channels;
    public:
        Form1(void)
        {
            InitializeComponent();

			theForm = this;
            _CalWizard = gcnew CalWizard;
			channels = gcnew array<Int32>(12);
        }
	private: System::Windows::Forms::GroupBox^  groupBox1;
	public: 
	private: System::Windows::Forms::Label^  label6;
	private: System::Windows::Forms::TextBox^  txtCh12;
	private: System::Windows::Forms::TextBox^  txtCh11;
	private: System::Windows::Forms::TextBox^  txtCh10;
	private: System::Windows::Forms::TextBox^  txtCh9;
	private: System::Windows::Forms::TextBox^  txtCh8;
	private: System::Windows::Forms::TextBox^  txtCh7;
	private: System::Windows::Forms::TextBox^  txtCh6;
	private: System::Windows::Forms::TextBox^  txtCh5;
	private: System::Windows::Forms::TextBox^  txtCh4;
	private: System::Windows::Forms::TextBox^  txtCh3;
	private: System::Windows::Forms::TextBox^  txtCh2;
	private: System::Windows::Forms::TextBox^  txtCh1;
	private: System::Windows::Forms::TabControl^  tabControl1;

	private: System::Windows::Forms::TabPage^  tabPage2;
	private: System::Windows::Forms::Button^  stop_HT;
	private: System::Windows::Forms::Button^  clear_plot;
	private: System::Windows::Forms::Button^  start_HT;
	private: System::Windows::Forms::DataVisualization::Charting::Chart^  chart1;
	private: System::Windows::Forms::TabPage^  tabPage1;
	private: System::Windows::Forms::PictureBox^  picDraw;

		static Form1^ theForm;
		//System::Void Form1::onReady();

    protected:
        /// <summary>
        /// Clean up any resources being used.
        /// </summary>
        ~Form1()
        {
            if (components)
            {
                delete components;
            }
        }
    
	public: 
		System::Windows::Forms::TextBox^  Serial_output_box;
        System::Void UpdateUIFromSettings(HTSETTINGS& Settings);
		System::Windows::Forms::Timer^  comPortTimer;
        
    private: 
    
        System::Windows::Forms::ComboBox^  dd_comport; 
        System::Windows::Forms::Button^  btn_connect;
        System::Windows::Forms::Button^  btn_disconnect;
        System::Windows::Forms::Timer^  timer1;

        System::Windows::Forms::Label^  Lowpass_text;
        System::Windows::Forms::TextBox^  textBox_LP_value;
        System::Windows::Forms::Button^  btn_update_headtracker;


        System::Windows::Forms::Label^  lbl_tilt_roll_gyro_weight;
        System::Windows::Forms::Label^  lbl_gyro_weight_pan;
        System::Windows::Forms::Label^  lbl_filter_pan;
        System::Windows::Forms::TextBox^  textBox_LP_valuePan;
        System::Windows::Forms::TextBox^  GyroWeight_tiltRoll;
        System::Windows::Forms::TextBox^  GyroWeight_pan;

        System::Windows::Forms::GroupBox^  groupBox2;
        System::Windows::Forms::Button^  btnCalibrate;
        System::Windows::Forms::GroupBox^  grpBoxServp2;
        System::Windows::Forms::MenuStrip^  menuStrip1;
        System::Windows::Forms::ToolStripMenuItem^  fileToolStripMenuItem;
        System::Windows::Forms::ToolStripMenuItem^  exitToolStripMenuItem;
        System::Windows::Forms::ToolStripMenuItem^  helpToolStripMenuItem;
        System::Windows::Forms::ToolStripMenuItem^  aboutToolStripMenuItem;
        System::Windows::Forms::TrackBar^  panCenterTrackBar;
        System::Windows::Forms::Label^  label14;
        System::Windows::Forms::Label^  label17;
        System::Windows::Forms::TrackBar^  panMaxTrackBar;
        System::Windows::Forms::Label^  label18;
        System::Windows::Forms::TrackBar^  panMinTrackBar;
        System::Windows::Forms::Label^  LblPanCenter;
        System::Windows::Forms::Label^  label27;
        System::Windows::Forms::Label^  label26;
        System::Windows::Forms::Label^  lblShowOutput;
        System::Windows::Forms::Label^  label22;
        System::Windows::Forms::TrackBar^  rollMaxTrackBar;
        System::Windows::Forms::Label^  label23;
        System::Windows::Forms::TrackBar^  rollMinTrackBar;
        System::Windows::Forms::Label^  label24;
        System::Windows::Forms::TrackBar^  rollCenterTrackBar;
        System::Windows::Forms::Label^  label19;
        System::Windows::Forms::TrackBar^  tiltMaxTrackBar;
        System::Windows::Forms::Label^  label20;
        System::Windows::Forms::TrackBar^  tiltMinTrackBar;
        System::Windows::Forms::Label^  label21;
        System::Windows::Forms::TrackBar^  tiltCenterTrackBar;
        System::Windows::Forms::Label^  label29;
        System::Windows::Forms::TrackBar^  rollGainTrackBar;
        System::Windows::Forms::Label^  label28;
        System::Windows::Forms::TrackBar^  tiltGainTrackBar;
        System::Windows::Forms::Label^  label25;
        System::Windows::Forms::TrackBar^  panGainTrackBar;
        System::Windows::Forms::ToolStripMenuItem^  toolsToolStripMenuItem;
        System::Windows::Forms::ToolStripMenuItem^  calibrationWizardToolStripMenuItem;
        System::Windows::Forms::ToolStripMenuItem^  exportSettingsToFileToolStripMenuItem;
        System::Windows::Forms::ToolStripMenuItem^  importSettingsFromFileToolStripMenuItem;
        System::Windows::Forms::ToolStripMenuItem^  calibrationWizardRotToolStripMenuItem;
        System::Windows::Forms::TextBox^  ManualCmdEdit;
        System::Windows::Forms::Button^  btnSendManualCmd;
        System::Windows::Forms::Label^  label5;
        System::Windows::Forms::CheckBox^  chk_roll;
        System::Windows::Forms::CheckBox^  chk_tilt;
        System::Windows::Forms::CheckBox^  chk_pan;
        System::Windows::Forms::TextBox^  servoGainPan;
        System::Windows::Forms::TextBox^  servoGainTilt;
        System::Windows::Forms::Label^  label42;
        System::Windows::Forms::TextBox^  inputPanCenter;
        System::Windows::Forms::TextBox^  inputPanTravlMin;
        System::Windows::Forms::Label^  lbl_servo_center;
        System::Windows::Forms::Label^  lbl_servo_max;
        System::Windows::Forms::Label^  Pan_lbl;
        System::Windows::Forms::TextBox^  inputPanTravlMax;
        System::Windows::Forms::Label^  label1;
        System::Windows::Forms::TextBox^  inputTiltCenter;
        System::Windows::Forms::TextBox^  inputTiltTravlMin;
        System::Windows::Forms::Label^  label3;
        System::Windows::Forms::TextBox^  inputTiltTravlMax;
        System::Windows::Forms::TextBox^  inputRollCenter;
        System::Windows::Forms::TextBox^  inputRollTravlMin;
        System::Windows::Forms::Label^  label7;
        System::Windows::Forms::TextBox^  inputRollTravlMax;
        System::Windows::Forms::TextBox^  servoGainRoll;
        System::Windows::Forms::ComboBox^  inputPanCh;
        System::Windows::Forms::Label^  label2;
        System::Windows::Forms::ComboBox^  inputTiltCh;
        System::Windows::Forms::Label^  label4;
        System::Windows::Forms::ComboBox^  inputRollCh;
        System::Windows::Forms::GroupBox^  rollCenter;

         System::ComponentModel::IContainer^  components;

    private:
        /// <summary>
        /// Required designer variable.
        /// </summary>


#pragma region Windows Form Designer generated code
        /// <summary>
        /// Required method for Designer support - do not modify
        /// the contents of this method with the code editor.
        /// </summary>
        void InitializeComponent(void)
        {
			this->components = (gcnew System::ComponentModel::Container());
			System::Windows::Forms::DataVisualization::Charting::ChartArea^  chartArea3 = (gcnew System::Windows::Forms::DataVisualization::Charting::ChartArea());
			System::Windows::Forms::DataVisualization::Charting::Legend^  legend3 = (gcnew System::Windows::Forms::DataVisualization::Charting::Legend());
			System::Windows::Forms::DataVisualization::Charting::Series^  series7 = (gcnew System::Windows::Forms::DataVisualization::Charting::Series());
			System::Windows::Forms::DataVisualization::Charting::Series^  series8 = (gcnew System::Windows::Forms::DataVisualization::Charting::Series());
			System::Windows::Forms::DataVisualization::Charting::Series^  series9 = (gcnew System::Windows::Forms::DataVisualization::Charting::Series());
			this->dd_comport = (gcnew System::Windows::Forms::ComboBox());
			this->btn_connect = (gcnew System::Windows::Forms::Button());
			this->btn_disconnect = (gcnew System::Windows::Forms::Button());
			this->timer1 = (gcnew System::Windows::Forms::Timer(this->components));
			this->comPortTimer = (gcnew System::Windows::Forms::Timer(this->components));
			this->Lowpass_text = (gcnew System::Windows::Forms::Label());
			this->Serial_output_box = (gcnew System::Windows::Forms::TextBox());
			this->textBox_LP_value = (gcnew System::Windows::Forms::TextBox());
			this->btn_update_headtracker = (gcnew System::Windows::Forms::Button());
			this->lbl_tilt_roll_gyro_weight = (gcnew System::Windows::Forms::Label());
			this->lbl_gyro_weight_pan = (gcnew System::Windows::Forms::Label());
			this->lbl_filter_pan = (gcnew System::Windows::Forms::Label());
			this->textBox_LP_valuePan = (gcnew System::Windows::Forms::TextBox());
			this->GyroWeight_tiltRoll = (gcnew System::Windows::Forms::TextBox());
			this->GyroWeight_pan = (gcnew System::Windows::Forms::TextBox());
			this->groupBox2 = (gcnew System::Windows::Forms::GroupBox());
			this->label5 = (gcnew System::Windows::Forms::Label());
			this->ManualCmdEdit = (gcnew System::Windows::Forms::TextBox());
			this->btnSendManualCmd = (gcnew System::Windows::Forms::Button());
			this->btnCalibrate = (gcnew System::Windows::Forms::Button());
			this->grpBoxServp2 = (gcnew System::Windows::Forms::GroupBox());
			this->label29 = (gcnew System::Windows::Forms::Label());
			this->rollGainTrackBar = (gcnew System::Windows::Forms::TrackBar());
			this->label28 = (gcnew System::Windows::Forms::Label());
			this->tiltGainTrackBar = (gcnew System::Windows::Forms::TrackBar());
			this->label25 = (gcnew System::Windows::Forms::Label());
			this->label27 = (gcnew System::Windows::Forms::Label());
			this->panGainTrackBar = (gcnew System::Windows::Forms::TrackBar());
			this->label26 = (gcnew System::Windows::Forms::Label());
			this->lblShowOutput = (gcnew System::Windows::Forms::Label());
			this->label22 = (gcnew System::Windows::Forms::Label());
			this->rollMaxTrackBar = (gcnew System::Windows::Forms::TrackBar());
			this->label23 = (gcnew System::Windows::Forms::Label());
			this->rollMinTrackBar = (gcnew System::Windows::Forms::TrackBar());
			this->label24 = (gcnew System::Windows::Forms::Label());
			this->rollCenterTrackBar = (gcnew System::Windows::Forms::TrackBar());
			this->label19 = (gcnew System::Windows::Forms::Label());
			this->tiltMaxTrackBar = (gcnew System::Windows::Forms::TrackBar());
			this->label20 = (gcnew System::Windows::Forms::Label());
			this->tiltMinTrackBar = (gcnew System::Windows::Forms::TrackBar());
			this->label21 = (gcnew System::Windows::Forms::Label());
			this->tiltCenterTrackBar = (gcnew System::Windows::Forms::TrackBar());
			this->label17 = (gcnew System::Windows::Forms::Label());
			this->panMaxTrackBar = (gcnew System::Windows::Forms::TrackBar());
			this->label18 = (gcnew System::Windows::Forms::Label());
			this->panMinTrackBar = (gcnew System::Windows::Forms::TrackBar());
			this->LblPanCenter = (gcnew System::Windows::Forms::Label());
			this->label14 = (gcnew System::Windows::Forms::Label());
			this->panCenterTrackBar = (gcnew System::Windows::Forms::TrackBar());
			this->menuStrip1 = (gcnew System::Windows::Forms::MenuStrip());
			this->fileToolStripMenuItem = (gcnew System::Windows::Forms::ToolStripMenuItem());
			this->exportSettingsToFileToolStripMenuItem = (gcnew System::Windows::Forms::ToolStripMenuItem());
			this->importSettingsFromFileToolStripMenuItem = (gcnew System::Windows::Forms::ToolStripMenuItem());
			this->exitToolStripMenuItem = (gcnew System::Windows::Forms::ToolStripMenuItem());
			this->toolsToolStripMenuItem = (gcnew System::Windows::Forms::ToolStripMenuItem());
			this->calibrationWizardToolStripMenuItem = (gcnew System::Windows::Forms::ToolStripMenuItem());
			this->calibrationWizardRotToolStripMenuItem = (gcnew System::Windows::Forms::ToolStripMenuItem());
			this->helpToolStripMenuItem = (gcnew System::Windows::Forms::ToolStripMenuItem());
			this->aboutToolStripMenuItem = (gcnew System::Windows::Forms::ToolStripMenuItem());
			this->chk_roll = (gcnew System::Windows::Forms::CheckBox());
			this->chk_tilt = (gcnew System::Windows::Forms::CheckBox());
			this->chk_pan = (gcnew System::Windows::Forms::CheckBox());
			this->servoGainPan = (gcnew System::Windows::Forms::TextBox());
			this->servoGainTilt = (gcnew System::Windows::Forms::TextBox());
			this->label42 = (gcnew System::Windows::Forms::Label());
			this->inputPanCenter = (gcnew System::Windows::Forms::TextBox());
			this->inputPanTravlMin = (gcnew System::Windows::Forms::TextBox());
			this->lbl_servo_center = (gcnew System::Windows::Forms::Label());
			this->lbl_servo_max = (gcnew System::Windows::Forms::Label());
			this->Pan_lbl = (gcnew System::Windows::Forms::Label());
			this->inputPanTravlMax = (gcnew System::Windows::Forms::TextBox());
			this->label1 = (gcnew System::Windows::Forms::Label());
			this->inputTiltCenter = (gcnew System::Windows::Forms::TextBox());
			this->inputTiltTravlMin = (gcnew System::Windows::Forms::TextBox());
			this->label3 = (gcnew System::Windows::Forms::Label());
			this->inputTiltTravlMax = (gcnew System::Windows::Forms::TextBox());
			this->inputRollCenter = (gcnew System::Windows::Forms::TextBox());
			this->inputRollTravlMin = (gcnew System::Windows::Forms::TextBox());
			this->label7 = (gcnew System::Windows::Forms::Label());
			this->inputRollTravlMax = (gcnew System::Windows::Forms::TextBox());
			this->servoGainRoll = (gcnew System::Windows::Forms::TextBox());
			this->inputPanCh = (gcnew System::Windows::Forms::ComboBox());
			this->label2 = (gcnew System::Windows::Forms::Label());
			this->inputTiltCh = (gcnew System::Windows::Forms::ComboBox());
			this->label4 = (gcnew System::Windows::Forms::Label());
			this->inputRollCh = (gcnew System::Windows::Forms::ComboBox());
			this->rollCenter = (gcnew System::Windows::Forms::GroupBox());
			this->groupBox1 = (gcnew System::Windows::Forms::GroupBox());
			this->label6 = (gcnew System::Windows::Forms::Label());
			this->txtCh12 = (gcnew System::Windows::Forms::TextBox());
			this->txtCh11 = (gcnew System::Windows::Forms::TextBox());
			this->txtCh10 = (gcnew System::Windows::Forms::TextBox());
			this->txtCh9 = (gcnew System::Windows::Forms::TextBox());
			this->txtCh8 = (gcnew System::Windows::Forms::TextBox());
			this->txtCh7 = (gcnew System::Windows::Forms::TextBox());
			this->txtCh6 = (gcnew System::Windows::Forms::TextBox());
			this->txtCh5 = (gcnew System::Windows::Forms::TextBox());
			this->txtCh4 = (gcnew System::Windows::Forms::TextBox());
			this->txtCh3 = (gcnew System::Windows::Forms::TextBox());
			this->txtCh2 = (gcnew System::Windows::Forms::TextBox());
			this->txtCh1 = (gcnew System::Windows::Forms::TextBox());
			this->tabControl1 = (gcnew System::Windows::Forms::TabControl());
			this->tabPage2 = (gcnew System::Windows::Forms::TabPage());
			this->stop_HT = (gcnew System::Windows::Forms::Button());
			this->clear_plot = (gcnew System::Windows::Forms::Button());
			this->start_HT = (gcnew System::Windows::Forms::Button());
			this->chart1 = (gcnew System::Windows::Forms::DataVisualization::Charting::Chart());
			this->tabPage1 = (gcnew System::Windows::Forms::TabPage());
			this->picDraw = (gcnew System::Windows::Forms::PictureBox());
			this->groupBox2->SuspendLayout();
			this->grpBoxServp2->SuspendLayout();
			(cli::safe_cast<System::ComponentModel::ISupportInitialize^  >(this->rollGainTrackBar))->BeginInit();
			(cli::safe_cast<System::ComponentModel::ISupportInitialize^  >(this->tiltGainTrackBar))->BeginInit();
			(cli::safe_cast<System::ComponentModel::ISupportInitialize^  >(this->panGainTrackBar))->BeginInit();
			(cli::safe_cast<System::ComponentModel::ISupportInitialize^  >(this->rollMaxTrackBar))->BeginInit();
			(cli::safe_cast<System::ComponentModel::ISupportInitialize^  >(this->rollMinTrackBar))->BeginInit();
			(cli::safe_cast<System::ComponentModel::ISupportInitialize^  >(this->rollCenterTrackBar))->BeginInit();
			(cli::safe_cast<System::ComponentModel::ISupportInitialize^  >(this->tiltMaxTrackBar))->BeginInit();
			(cli::safe_cast<System::ComponentModel::ISupportInitialize^  >(this->tiltMinTrackBar))->BeginInit();
			(cli::safe_cast<System::ComponentModel::ISupportInitialize^  >(this->tiltCenterTrackBar))->BeginInit();
			(cli::safe_cast<System::ComponentModel::ISupportInitialize^  >(this->panMaxTrackBar))->BeginInit();
			(cli::safe_cast<System::ComponentModel::ISupportInitialize^  >(this->panMinTrackBar))->BeginInit();
			(cli::safe_cast<System::ComponentModel::ISupportInitialize^  >(this->panCenterTrackBar))->BeginInit();
			this->menuStrip1->SuspendLayout();
			this->rollCenter->SuspendLayout();
			this->groupBox1->SuspendLayout();
			this->tabControl1->SuspendLayout();
			this->tabPage2->SuspendLayout();
			(cli::safe_cast<System::ComponentModel::ISupportInitialize^  >(this->chart1))->BeginInit();
			this->tabPage1->SuspendLayout();
			(cli::safe_cast<System::ComponentModel::ISupportInitialize^  >(this->picDraw))->BeginInit();
			this->SuspendLayout();
			// 
			// dd_comport
			// 
			this->dd_comport->FormattingEnabled = true;
			this->dd_comport->Items->AddRange(gcnew cli::array< System::Object^  >(30) {L"COM1", L"COM2", L"COM3", L"COM4", L"COM5", L"COM6", 
				L"COM7", L"COM8", L"COM9", L"COM10", L"COM11", L"COM12", L"COM13", L"COM14", L"COM15", L"COM16", L"COM17", L"COM18", L"COM19", 
				L"COM20", L"COM21", L"COM22", L"COM23", L"COM24", L"COM25", L"COM26", L"COM27", L"COM28", L"COM29", L"COM30"});
			this->dd_comport->Location = System::Drawing::Point(12, 43);
			this->dd_comport->Name = L"dd_comport";
			this->dd_comport->Size = System::Drawing::Size(93, 21);
			this->dd_comport->TabIndex = 0;
			this->dd_comport->Text = L"COM1";
			// 
			// btn_connect
			// 
			this->btn_connect->Location = System::Drawing::Point(12, 75);
			this->btn_connect->Name = L"btn_connect";
			this->btn_connect->Size = System::Drawing::Size(93, 23);
			this->btn_connect->TabIndex = 1;
			this->btn_connect->Text = L"&Connect";
			this->btn_connect->UseVisualStyleBackColor = true;
			this->btn_connect->Click += gcnew System::EventHandler(this, &Form1::btn_connect_Click);
			// 
			// btn_disconnect
			// 
			this->btn_disconnect->Enabled = false;
			this->btn_disconnect->Location = System::Drawing::Point(12, 105);
			this->btn_disconnect->Name = L"btn_disconnect";
			this->btn_disconnect->Size = System::Drawing::Size(93, 23);
			this->btn_disconnect->TabIndex = 2;
			this->btn_disconnect->Text = L"&Disconnect";
			this->btn_disconnect->UseVisualStyleBackColor = true;
			this->btn_disconnect->Click += gcnew System::EventHandler(this, &Form1::btn_disconnect_Click);
			// 
			// timer1
			// 
			this->timer1->Interval = 50;
			this->timer1->Tick += gcnew System::EventHandler(this, &Form1::timer1_Tick);
			// 
			// comPortTimer
			// 
			this->comPortTimer->Enabled = true;
			this->comPortTimer->Interval = 2000;
			this->comPortTimer->Tick += gcnew System::EventHandler(this, &Form1::comPortTimer_Tick);
			// 
			// Lowpass_text
			// 
			this->Lowpass_text->AutoSize = true;
			this->Lowpass_text->Location = System::Drawing::Point(44, 57);
			this->Lowpass_text->Name = L"Lowpass_text";
			this->Lowpass_text->Size = System::Drawing::Size(147, 13);
			this->Lowpass_text->TabIndex = 79;
			this->Lowpass_text->Text = L"LP filter beta on tilt/roll [1-1/n]";
			// 
			// Serial_output_box
			// 
			this->Serial_output_box->Location = System::Drawing::Point(122, 43);
			this->Serial_output_box->Multiline = true;
			this->Serial_output_box->Name = L"Serial_output_box";
			this->Serial_output_box->ScrollBars = System::Windows::Forms::ScrollBars::Vertical;
			this->Serial_output_box->Size = System::Drawing::Size(321, 165);
			this->Serial_output_box->TabIndex = 80;
			// 
			// textBox_LP_value
			// 
			this->textBox_LP_value->Location = System::Drawing::Point(196, 54);
			this->textBox_LP_value->Name = L"textBox_LP_value";
			this->textBox_LP_value->Size = System::Drawing::Size(41, 20);
			this->textBox_LP_value->TabIndex = 81;
			this->textBox_LP_value->Text = L"10";
			// 
			// btn_update_headtracker
			// 
			this->btn_update_headtracker->Enabled = false;
			this->btn_update_headtracker->Location = System::Drawing::Point(12, 164);
			this->btn_update_headtracker->Name = L"btn_update_headtracker";
			this->btn_update_headtracker->Size = System::Drawing::Size(93, 23);
			this->btn_update_headtracker->TabIndex = 82;
			this->btn_update_headtracker->Text = L"Store Settings";
			this->btn_update_headtracker->UseVisualStyleBackColor = true;
			this->btn_update_headtracker->Click += gcnew System::EventHandler(this, &Form1::btn_update_headtracker_Click);
			// 
			// lbl_tilt_roll_gyro_weight
			// 
			this->lbl_tilt_roll_gyro_weight->AutoSize = true;
			this->lbl_tilt_roll_gyro_weight->Location = System::Drawing::Point(47, 80);
			this->lbl_tilt_roll_gyro_weight->Name = L"lbl_tilt_roll_gyro_weight";
			this->lbl_tilt_roll_gyro_weight->Size = System::Drawing::Size(144, 13);
			this->lbl_tilt_roll_gyro_weight->TabIndex = 115;
			this->lbl_tilt_roll_gyro_weight->Text = L"Gyro weight on tilt/roll [1-1/k]";
			// 
			// lbl_gyro_weight_pan
			// 
			this->lbl_gyro_weight_pan->AutoSize = true;
			this->lbl_gyro_weight_pan->Location = System::Drawing::Point(56, 126);
			this->lbl_gyro_weight_pan->Name = L"lbl_gyro_weight_pan";
			this->lbl_gyro_weight_pan->Size = System::Drawing::Size(134, 13);
			this->lbl_gyro_weight_pan->TabIndex = 116;
			this->lbl_gyro_weight_pan->Text = L"Gyro weight on pan [1-1/k]";
			this->lbl_gyro_weight_pan->Click += gcnew System::EventHandler(this, &Form1::lbl_gyro_weight_pan_Click);
			// 
			// lbl_filter_pan
			// 
			this->lbl_filter_pan->AutoSize = true;
			this->lbl_filter_pan->Location = System::Drawing::Point(53, 103);
			this->lbl_filter_pan->Name = L"lbl_filter_pan";
			this->lbl_filter_pan->Size = System::Drawing::Size(137, 13);
			this->lbl_filter_pan->TabIndex = 117;
			this->lbl_filter_pan->Text = L"LP filter beta on pan [1-1/n]";
			// 
			// textBox_LP_valuePan
			// 
			this->textBox_LP_valuePan->Location = System::Drawing::Point(196, 100);
			this->textBox_LP_valuePan->Name = L"textBox_LP_valuePan";
			this->textBox_LP_valuePan->Size = System::Drawing::Size(41, 20);
			this->textBox_LP_valuePan->TabIndex = 118;
			this->textBox_LP_valuePan->Text = L"10";
			// 
			// GyroWeight_tiltRoll
			// 
			this->GyroWeight_tiltRoll->Location = System::Drawing::Point(196, 77);
			this->GyroWeight_tiltRoll->Name = L"GyroWeight_tiltRoll";
			this->GyroWeight_tiltRoll->Size = System::Drawing::Size(41, 20);
			this->GyroWeight_tiltRoll->TabIndex = 119;
			this->GyroWeight_tiltRoll->Text = L"50";
			// 
			// GyroWeight_pan
			// 
			this->GyroWeight_pan->Location = System::Drawing::Point(196, 123);
			this->GyroWeight_pan->Name = L"GyroWeight_pan";
			this->GyroWeight_pan->Size = System::Drawing::Size(41, 20);
			this->GyroWeight_pan->TabIndex = 120;
			this->GyroWeight_pan->Text = L"50";
			// 
			// groupBox2
			// 
			this->groupBox2->Controls->Add(this->label5);
			this->groupBox2->Controls->Add(this->ManualCmdEdit);
			this->groupBox2->Controls->Add(this->btnSendManualCmd);
			this->groupBox2->Controls->Add(this->Lowpass_text);
			this->groupBox2->Controls->Add(this->textBox_LP_value);
			this->groupBox2->Controls->Add(this->lbl_tilt_roll_gyro_weight);
			this->groupBox2->Controls->Add(this->GyroWeight_pan);
			this->groupBox2->Controls->Add(this->lbl_gyro_weight_pan);
			this->groupBox2->Controls->Add(this->GyroWeight_tiltRoll);
			this->groupBox2->Controls->Add(this->lbl_filter_pan);
			this->groupBox2->Controls->Add(this->textBox_LP_valuePan);
			this->groupBox2->Location = System::Drawing::Point(457, 43);
			this->groupBox2->Name = L"groupBox2";
			this->groupBox2->Size = System::Drawing::Size(260, 165);
			this->groupBox2->TabIndex = 134;
			this->groupBox2->TabStop = false;
			this->groupBox2->Text = L"Advanced Parameters";
			// 
			// label5
			// 
			this->label5->AutoSize = true;
			this->label5->Location = System::Drawing::Point(87, 15);
			this->label5->Name = L"label5";
			this->label5->Size = System::Drawing::Size(92, 13);
			this->label5->TabIndex = 142;
			this->label5->Text = L"Manual Command";
			// 
			// ManualCmdEdit
			// 
			this->ManualCmdEdit->Location = System::Drawing::Point(12, 31);
			this->ManualCmdEdit->MaxLength = 100;
			this->ManualCmdEdit->Name = L"ManualCmdEdit";
			this->ManualCmdEdit->Size = System::Drawing::Size(178, 20);
			this->ManualCmdEdit->TabIndex = 140;
			this->ManualCmdEdit->WordWrap = false;
			this->ManualCmdEdit->Enter += gcnew System::EventHandler(this, &Form1::ManualCmdEdit_OnFocusEnter);
			this->ManualCmdEdit->KeyDown += gcnew System::Windows::Forms::KeyEventHandler(this, &Form1::ManualCmdEdit_OnKeyDown);
			// 
			// btnSendManualCmd
			// 
			this->btnSendManualCmd->Enabled = false;
			this->btnSendManualCmd->Location = System::Drawing::Point(196, 29);
			this->btnSendManualCmd->Name = L"btnSendManualCmd";
			this->btnSendManualCmd->Size = System::Drawing::Size(50, 23);
			this->btnSendManualCmd->TabIndex = 141;
			this->btnSendManualCmd->Text = L"Send";
			this->btnSendManualCmd->UseVisualStyleBackColor = true;
			this->btnSendManualCmd->Click += gcnew System::EventHandler(this, &Form1::btnSendManualCmd_Click);
			// 
			// btnCalibrate
			// 
			this->btnCalibrate->Enabled = false;
			this->btnCalibrate->Location = System::Drawing::Point(12, 135);
			this->btnCalibrate->Name = L"btnCalibrate";
			this->btnCalibrate->Size = System::Drawing::Size(93, 23);
			this->btnCalibrate->TabIndex = 137;
			this->btnCalibrate->Text = L"Calibrate";
			this->btnCalibrate->UseVisualStyleBackColor = true;
			this->btnCalibrate->Click += gcnew System::EventHandler(this, &Form1::btnCalibrate_Click);
			// 
			// grpBoxServp2
			// 
			this->grpBoxServp2->Controls->Add(this->label29);
			this->grpBoxServp2->Controls->Add(this->rollGainTrackBar);
			this->grpBoxServp2->Controls->Add(this->label28);
			this->grpBoxServp2->Controls->Add(this->tiltGainTrackBar);
			this->grpBoxServp2->Controls->Add(this->label25);
			this->grpBoxServp2->Controls->Add(this->label27);
			this->grpBoxServp2->Controls->Add(this->panGainTrackBar);
			this->grpBoxServp2->Controls->Add(this->label26);
			this->grpBoxServp2->Controls->Add(this->lblShowOutput);
			this->grpBoxServp2->Controls->Add(this->label22);
			this->grpBoxServp2->Controls->Add(this->rollMaxTrackBar);
			this->grpBoxServp2->Controls->Add(this->label23);
			this->grpBoxServp2->Controls->Add(this->rollMinTrackBar);
			this->grpBoxServp2->Controls->Add(this->label24);
			this->grpBoxServp2->Controls->Add(this->rollCenterTrackBar);
			this->grpBoxServp2->Controls->Add(this->label19);
			this->grpBoxServp2->Controls->Add(this->tiltMaxTrackBar);
			this->grpBoxServp2->Controls->Add(this->label20);
			this->grpBoxServp2->Controls->Add(this->tiltMinTrackBar);
			this->grpBoxServp2->Controls->Add(this->label21);
			this->grpBoxServp2->Controls->Add(this->tiltCenterTrackBar);
			this->grpBoxServp2->Controls->Add(this->label17);
			this->grpBoxServp2->Controls->Add(this->panMaxTrackBar);
			this->grpBoxServp2->Controls->Add(this->label18);
			this->grpBoxServp2->Controls->Add(this->panMinTrackBar);
			this->grpBoxServp2->Controls->Add(this->LblPanCenter);
			this->grpBoxServp2->Controls->Add(this->label14);
			this->grpBoxServp2->Controls->Add(this->panCenterTrackBar);
			this->grpBoxServp2->Location = System::Drawing::Point(13, 214);
			this->grpBoxServp2->Name = L"grpBoxServp2";
			this->grpBoxServp2->Size = System::Drawing::Size(430, 229);
			this->grpBoxServp2->TabIndex = 138;
			this->grpBoxServp2->TabStop = false;
			this->grpBoxServp2->Text = L"Servo";
			// 
			// label29
			// 
			this->label29->AutoSize = true;
			this->label29->Location = System::Drawing::Point(331, 170);
			this->label29->Name = L"label29";
			this->label29->Size = System::Drawing::Size(29, 13);
			this->label29->TabIndex = 178;
			this->label29->Text = L"Gain";
			// 
			// rollGainTrackBar
			// 
			this->rollGainTrackBar->Location = System::Drawing::Point(288, 181);
			this->rollGainTrackBar->Maximum = 500;
			this->rollGainTrackBar->Name = L"rollGainTrackBar";
			this->rollGainTrackBar->Size = System::Drawing::Size(130, 42);
			this->rollGainTrackBar->TabIndex = 177;
			this->rollGainTrackBar->TickStyle = System::Windows::Forms::TickStyle::None;
			this->rollGainTrackBar->Value = 170;
			this->rollGainTrackBar->ValueChanged += gcnew System::EventHandler(this, &Form1::RollGainTrackBar_ValueChanged);
			// 
			// label28
			// 
			this->label28->AutoSize = true;
			this->label28->Location = System::Drawing::Point(190, 170);
			this->label28->Name = L"label28";
			this->label28->Size = System::Drawing::Size(29, 13);
			this->label28->TabIndex = 176;
			this->label28->Text = L"Gain";
			// 
			// tiltGainTrackBar
			// 
			this->tiltGainTrackBar->Location = System::Drawing::Point(147, 181);
			this->tiltGainTrackBar->Maximum = 500;
			this->tiltGainTrackBar->Name = L"tiltGainTrackBar";
			this->tiltGainTrackBar->Size = System::Drawing::Size(130, 42);
			this->tiltGainTrackBar->TabIndex = 175;
			this->tiltGainTrackBar->TickStyle = System::Windows::Forms::TickStyle::None;
			this->tiltGainTrackBar->Value = 170;
			this->tiltGainTrackBar->ValueChanged += gcnew System::EventHandler(this, &Form1::TiltGainTrackBar_ValueChanged);
			// 
			// label25
			// 
			this->label25->AutoSize = true;
			this->label25->Location = System::Drawing::Point(54, 170);
			this->label25->Name = L"label25";
			this->label25->Size = System::Drawing::Size(29, 13);
			this->label25->TabIndex = 174;
			this->label25->Text = L"Gain";
			// 
			// label27
			// 
			this->label27->AutoSize = true;
			this->label27->Font = (gcnew System::Drawing::Font(L"Microsoft Sans Serif", 8.25F, static_cast<System::Drawing::FontStyle>((System::Drawing::FontStyle::Bold | System::Drawing::FontStyle::Underline)), 
				System::Drawing::GraphicsUnit::Point, static_cast<System::Byte>(0)));
			this->label27->Location = System::Drawing::Point(334, 19);
			this->label27->Name = L"label27";
			this->label27->Size = System::Drawing::Size(29, 13);
			this->label27->TabIndex = 152;
			this->label27->Text = L"Roll";
			// 
			// panGainTrackBar
			// 
			this->panGainTrackBar->Location = System::Drawing::Point(11, 181);
			this->panGainTrackBar->Maximum = 500;
			this->panGainTrackBar->Name = L"panGainTrackBar";
			this->panGainTrackBar->Size = System::Drawing::Size(130, 42);
			this->panGainTrackBar->TabIndex = 173;
			this->panGainTrackBar->TickStyle = System::Windows::Forms::TickStyle::None;
			this->panGainTrackBar->Value = 170;
			this->panGainTrackBar->ValueChanged += gcnew System::EventHandler(this, &Form1::PanGainTrackBar_ValueChanged);
			// 
			// label26
			// 
			this->label26->AutoSize = true;
			this->label26->Font = (gcnew System::Drawing::Font(L"Microsoft Sans Serif", 8.25F, static_cast<System::Drawing::FontStyle>((System::Drawing::FontStyle::Bold | System::Drawing::FontStyle::Underline)), 
				System::Drawing::GraphicsUnit::Point, static_cast<System::Byte>(0)));
			this->label26->Location = System::Drawing::Point(196, 19);
			this->label26->Name = L"label26";
			this->label26->Size = System::Drawing::Size(25, 13);
			this->label26->TabIndex = 152;
			this->label26->Text = L"Tilt";
			// 
			// lblShowOutput
			// 
			this->lblShowOutput->AutoSize = true;
			this->lblShowOutput->Location = System::Drawing::Point(463, 200);
			this->lblShowOutput->Name = L"lblShowOutput";
			this->lblShowOutput->Size = System::Drawing::Size(0, 13);
			this->lblShowOutput->TabIndex = 172;
			// 
			// label22
			// 
			this->label22->AutoSize = true;
			this->label22->Location = System::Drawing::Point(331, 127);
			this->label22->Name = L"label22";
			this->label22->Size = System::Drawing::Size(38, 13);
			this->label22->TabIndex = 171;
			this->label22->Text = L"<- End";
			// 
			// rollMaxTrackBar
			// 
			this->rollMaxTrackBar->Location = System::Drawing::Point(288, 138);
			this->rollMaxTrackBar->Maximum = 2200;
			this->rollMaxTrackBar->Name = L"rollMaxTrackBar";
			this->rollMaxTrackBar->Size = System::Drawing::Size(130, 42);
			this->rollMaxTrackBar->TabIndex = 170;
			this->rollMaxTrackBar->TickStyle = System::Windows::Forms::TickStyle::None;
			this->rollMaxTrackBar->Value = 2150;
			this->rollMaxTrackBar->ValueChanged += gcnew System::EventHandler(this, &Form1::RollMaxTrackBar_ValueChanged);
			// 
			// label23
			// 
			this->label23->AutoSize = true;
			this->label23->Location = System::Drawing::Point(331, 85);
			this->label23->Name = L"label23";
			this->label23->Size = System::Drawing::Size(38, 13);
			this->label23->TabIndex = 169;
			this->label23->Text = L"End ->";
			// 
			// rollMinTrackBar
			// 
			this->rollMinTrackBar->Location = System::Drawing::Point(287, 93);
			this->rollMinTrackBar->Maximum = 1500;
			this->rollMinTrackBar->Name = L"rollMinTrackBar";
			this->rollMinTrackBar->Size = System::Drawing::Size(130, 42);
			this->rollMinTrackBar->TabIndex = 168;
			this->rollMinTrackBar->TickStyle = System::Windows::Forms::TickStyle::None;
			this->rollMinTrackBar->Value = 1150;
			this->rollMinTrackBar->ValueChanged += gcnew System::EventHandler(this, &Form1::RollMinTrackBar_ValueChanged);
			// 
			// label24
			// 
			this->label24->AutoSize = true;
			this->label24->Location = System::Drawing::Point(331, 43);
			this->label24->Name = L"label24";
			this->label24->Size = System::Drawing::Size(38, 13);
			this->label24->TabIndex = 167;
			this->label24->Text = L"Center";
			// 
			// rollCenterTrackBar
			// 
			this->rollCenterTrackBar->Location = System::Drawing::Point(288, 56);
			this->rollCenterTrackBar->Maximum = 2200;
			this->rollCenterTrackBar->Minimum = 900;
			this->rollCenterTrackBar->Name = L"rollCenterTrackBar";
			this->rollCenterTrackBar->Size = System::Drawing::Size(130, 42);
			this->rollCenterTrackBar->TabIndex = 166;
			this->rollCenterTrackBar->TickStyle = System::Windows::Forms::TickStyle::None;
			this->rollCenterTrackBar->Value = 900;
			this->rollCenterTrackBar->ValueChanged += gcnew System::EventHandler(this, &Form1::RollCenterTrackBar_ValueChanged);
			// 
			// label19
			// 
			this->label19->AutoSize = true;
			this->label19->Location = System::Drawing::Point(190, 127);
			this->label19->Name = L"label19";
			this->label19->Size = System::Drawing::Size(38, 13);
			this->label19->TabIndex = 165;
			this->label19->Text = L"<- End";
			// 
			// tiltMaxTrackBar
			// 
			this->tiltMaxTrackBar->Location = System::Drawing::Point(147, 138);
			this->tiltMaxTrackBar->Maximum = 2200;
			this->tiltMaxTrackBar->Name = L"tiltMaxTrackBar";
			this->tiltMaxTrackBar->Size = System::Drawing::Size(130, 42);
			this->tiltMaxTrackBar->TabIndex = 164;
			this->tiltMaxTrackBar->TickStyle = System::Windows::Forms::TickStyle::None;
			this->tiltMaxTrackBar->Value = 2150;
			this->tiltMaxTrackBar->ValueChanged += gcnew System::EventHandler(this, &Form1::TiltMaxTrackBar_ValueChanged);
			// 
			// label20
			// 
			this->label20->AutoSize = true;
			this->label20->Location = System::Drawing::Point(190, 85);
			this->label20->Name = L"label20";
			this->label20->Size = System::Drawing::Size(38, 13);
			this->label20->TabIndex = 163;
			this->label20->Text = L"End ->";
			// 
			// tiltMinTrackBar
			// 
			this->tiltMinTrackBar->Location = System::Drawing::Point(146, 93);
			this->tiltMinTrackBar->Maximum = 1500;
			this->tiltMinTrackBar->Name = L"tiltMinTrackBar";
			this->tiltMinTrackBar->Size = System::Drawing::Size(130, 42);
			this->tiltMinTrackBar->TabIndex = 162;
			this->tiltMinTrackBar->TickStyle = System::Windows::Forms::TickStyle::None;
			this->tiltMinTrackBar->Value = 1150;
			this->tiltMinTrackBar->ValueChanged += gcnew System::EventHandler(this, &Form1::TiltMinTrackBar_ValueChanged);
			// 
			// label21
			// 
			this->label21->AutoSize = true;
			this->label21->Location = System::Drawing::Point(190, 43);
			this->label21->Name = L"label21";
			this->label21->Size = System::Drawing::Size(38, 13);
			this->label21->TabIndex = 161;
			this->label21->Text = L"Center";
			// 
			// tiltCenterTrackBar
			// 
			this->tiltCenterTrackBar->Location = System::Drawing::Point(147, 56);
			this->tiltCenterTrackBar->Maximum = 2200;
			this->tiltCenterTrackBar->Minimum = 90;
			this->tiltCenterTrackBar->Name = L"tiltCenterTrackBar";
			this->tiltCenterTrackBar->Size = System::Drawing::Size(130, 42);
			this->tiltCenterTrackBar->TabIndex = 160;
			this->tiltCenterTrackBar->TickStyle = System::Windows::Forms::TickStyle::None;
			this->tiltCenterTrackBar->Value = 90;
			this->tiltCenterTrackBar->ValueChanged += gcnew System::EventHandler(this, &Form1::TiltCenterTrackBar_ValueChanged);
			// 
			// label17
			// 
			this->label17->AutoSize = true;
			this->label17->Location = System::Drawing::Point(54, 127);
			this->label17->Name = L"label17";
			this->label17->Size = System::Drawing::Size(38, 13);
			this->label17->TabIndex = 159;
			this->label17->Text = L"<- End";
			// 
			// panMaxTrackBar
			// 
			this->panMaxTrackBar->Location = System::Drawing::Point(11, 138);
			this->panMaxTrackBar->Maximum = 2200;
			this->panMaxTrackBar->Name = L"panMaxTrackBar";
			this->panMaxTrackBar->Size = System::Drawing::Size(130, 42);
			this->panMaxTrackBar->TabIndex = 158;
			this->panMaxTrackBar->TickStyle = System::Windows::Forms::TickStyle::None;
			this->panMaxTrackBar->Value = 2150;
			this->panMaxTrackBar->ValueChanged += gcnew System::EventHandler(this, &Form1::PanMaxTrackBar_ValueChanged);
			// 
			// label18
			// 
			this->label18->AutoSize = true;
			this->label18->Location = System::Drawing::Point(54, 85);
			this->label18->Name = L"label18";
			this->label18->Size = System::Drawing::Size(38, 13);
			this->label18->TabIndex = 157;
			this->label18->Text = L"End ->";
			// 
			// panMinTrackBar
			// 
			this->panMinTrackBar->Location = System::Drawing::Point(10, 93);
			this->panMinTrackBar->Maximum = 1500;
			this->panMinTrackBar->Name = L"panMinTrackBar";
			this->panMinTrackBar->Size = System::Drawing::Size(130, 42);
			this->panMinTrackBar->TabIndex = 156;
			this->panMinTrackBar->TickStyle = System::Windows::Forms::TickStyle::None;
			this->panMinTrackBar->Value = 1150;
			this->panMinTrackBar->ValueChanged += gcnew System::EventHandler(this, &Form1::PanMinTrackBar_ValueChanged);
			// 
			// LblPanCenter
			// 
			this->LblPanCenter->AutoSize = true;
			this->LblPanCenter->Location = System::Drawing::Point(54, 43);
			this->LblPanCenter->Name = L"LblPanCenter";
			this->LblPanCenter->Size = System::Drawing::Size(38, 13);
			this->LblPanCenter->TabIndex = 153;
			this->LblPanCenter->Text = L"Center";
			// 
			// label14
			// 
			this->label14->AutoSize = true;
			this->label14->Font = (gcnew System::Drawing::Font(L"Microsoft Sans Serif", 8.25F, static_cast<System::Drawing::FontStyle>((System::Drawing::FontStyle::Bold | System::Drawing::FontStyle::Underline)), 
				System::Drawing::GraphicsUnit::Point, static_cast<System::Byte>(0)));
			this->label14->Location = System::Drawing::Point(56, 19);
			this->label14->Name = L"label14";
			this->label14->Size = System::Drawing::Size(29, 13);
			this->label14->TabIndex = 152;
			this->label14->Text = L"Pan";
			// 
			// panCenterTrackBar
			// 
			this->panCenterTrackBar->Location = System::Drawing::Point(11, 56);
			this->panCenterTrackBar->Maximum = 2200;
			this->panCenterTrackBar->Minimum = 900;
			this->panCenterTrackBar->Name = L"panCenterTrackBar";
			this->panCenterTrackBar->Size = System::Drawing::Size(130, 42);
			this->panCenterTrackBar->TabIndex = 140;
			this->panCenterTrackBar->TickStyle = System::Windows::Forms::TickStyle::None;
			this->panCenterTrackBar->Value = 900;
			this->panCenterTrackBar->ValueChanged += gcnew System::EventHandler(this, &Form1::PanCenterTrackBar_ValueChanged);
			// 
			// menuStrip1
			// 
			this->menuStrip1->BackColor = System::Drawing::Color::WhiteSmoke;
			this->menuStrip1->Items->AddRange(gcnew cli::array< System::Windows::Forms::ToolStripItem^  >(3) {this->fileToolStripMenuItem, 
				this->toolsToolStripMenuItem, this->helpToolStripMenuItem});
			this->menuStrip1->Location = System::Drawing::Point(0, 0);
			this->menuStrip1->Name = L"menuStrip1";
			this->menuStrip1->Size = System::Drawing::Size(792, 24);
			this->menuStrip1->TabIndex = 139;
			this->menuStrip1->Text = L"menuStrip1";
			// 
			// fileToolStripMenuItem
			// 
			this->fileToolStripMenuItem->DropDownItems->AddRange(gcnew cli::array< System::Windows::Forms::ToolStripItem^  >(3) {this->exportSettingsToFileToolStripMenuItem, 
				this->importSettingsFromFileToolStripMenuItem, this->exitToolStripMenuItem});
			this->fileToolStripMenuItem->Name = L"fileToolStripMenuItem";
			this->fileToolStripMenuItem->Size = System::Drawing::Size(35, 20);
			this->fileToolStripMenuItem->Text = L"File";
			// 
			// exportSettingsToFileToolStripMenuItem
			// 
			this->exportSettingsToFileToolStripMenuItem->Name = L"exportSettingsToFileToolStripMenuItem";
			this->exportSettingsToFileToolStripMenuItem->Size = System::Drawing::Size(217, 22);
			this->exportSettingsToFileToolStripMenuItem->Text = L"Export Settings to File...";
			this->exportSettingsToFileToolStripMenuItem->Click += gcnew System::EventHandler(this, &Form1::OnExportSettingsToFile_Menu);
			// 
			// importSettingsFromFileToolStripMenuItem
			// 
			this->importSettingsFromFileToolStripMenuItem->Name = L"importSettingsFromFileToolStripMenuItem";
			this->importSettingsFromFileToolStripMenuItem->Size = System::Drawing::Size(217, 22);
			this->importSettingsFromFileToolStripMenuItem->Text = L"Import Settings From File...";
			this->importSettingsFromFileToolStripMenuItem->Click += gcnew System::EventHandler(this, &Form1::OnImportSettingsFromFile_Menu);
			// 
			// exitToolStripMenuItem
			// 
			this->exitToolStripMenuItem->Name = L"exitToolStripMenuItem";
			this->exitToolStripMenuItem->Size = System::Drawing::Size(217, 22);
			this->exitToolStripMenuItem->Text = L"Exit";
			this->exitToolStripMenuItem->Click += gcnew System::EventHandler(this, &Form1::exitToolStripMenuItem_Click);
			// 
			// toolsToolStripMenuItem
			// 
			this->toolsToolStripMenuItem->DropDownItems->AddRange(gcnew cli::array< System::Windows::Forms::ToolStripItem^  >(2) {this->calibrationWizardToolStripMenuItem, 
				this->calibrationWizardRotToolStripMenuItem});
			this->toolsToolStripMenuItem->Name = L"toolsToolStripMenuItem";
			this->toolsToolStripMenuItem->Size = System::Drawing::Size(44, 20);
			this->toolsToolStripMenuItem->Text = L"Tools";
			// 
			// calibrationWizardToolStripMenuItem
			// 
			this->calibrationWizardToolStripMenuItem->Enabled = false;
			this->calibrationWizardToolStripMenuItem->Name = L"calibrationWizardToolStripMenuItem";
			this->calibrationWizardToolStripMenuItem->Size = System::Drawing::Size(275, 22);
			this->calibrationWizardToolStripMenuItem->Text = L"Calibration Wizard (Axis Method)...";
			this->calibrationWizardToolStripMenuItem->Click += gcnew System::EventHandler(this, &Form1::OnCalWizard_Menu);
			// 
			// calibrationWizardRotToolStripMenuItem
			// 
			this->calibrationWizardRotToolStripMenuItem->Enabled = false;
			this->calibrationWizardRotToolStripMenuItem->Name = L"calibrationWizardRotToolStripMenuItem";
			this->calibrationWizardRotToolStripMenuItem->Size = System::Drawing::Size(275, 22);
			this->calibrationWizardRotToolStripMenuItem->Text = L"Calibration Wizard (Rotation Method)...";
			this->calibrationWizardRotToolStripMenuItem->Click += gcnew System::EventHandler(this, &Form1::OnCalWizardRot_Menu);
			// 
			// helpToolStripMenuItem
			// 
			this->helpToolStripMenuItem->DropDownItems->AddRange(gcnew cli::array< System::Windows::Forms::ToolStripItem^  >(1) {this->aboutToolStripMenuItem});
			this->helpToolStripMenuItem->Name = L"helpToolStripMenuItem";
			this->helpToolStripMenuItem->Size = System::Drawing::Size(40, 20);
			this->helpToolStripMenuItem->Text = L"Help";
			// 
			// aboutToolStripMenuItem
			// 
			this->aboutToolStripMenuItem->Name = L"aboutToolStripMenuItem";
			this->aboutToolStripMenuItem->Size = System::Drawing::Size(114, 22);
			this->aboutToolStripMenuItem->Text = L"About";
			this->aboutToolStripMenuItem->Click += gcnew System::EventHandler(this, &Form1::aboutToolStripMenuItem_Click);
			// 
			// chk_roll
			// 
			this->chk_roll->AutoSize = true;
			this->chk_roll->Location = System::Drawing::Point(191, 153);
			this->chk_roll->Name = L"chk_roll";
			this->chk_roll->Size = System::Drawing::Size(44, 17);
			this->chk_roll->TabIndex = 131;
			this->chk_roll->Text = L"Roll";
			this->chk_roll->UseVisualStyleBackColor = true;
			// 
			// chk_tilt
			// 
			this->chk_tilt->AutoSize = true;
			this->chk_tilt->Location = System::Drawing::Point(139, 153);
			this->chk_tilt->Name = L"chk_tilt";
			this->chk_tilt->Size = System::Drawing::Size(40, 17);
			this->chk_tilt->TabIndex = 130;
			this->chk_tilt->Text = L"Tilt";
			this->chk_tilt->UseVisualStyleBackColor = true;
			// 
			// chk_pan
			// 
			this->chk_pan->AutoSize = true;
			this->chk_pan->Location = System::Drawing::Point(88, 153);
			this->chk_pan->Name = L"chk_pan";
			this->chk_pan->Size = System::Drawing::Size(45, 17);
			this->chk_pan->TabIndex = 132;
			this->chk_pan->Text = L"Pan";
			this->chk_pan->UseVisualStyleBackColor = true;
			// 
			// servoGainPan
			// 
			this->servoGainPan->Location = System::Drawing::Point(87, 127);
			this->servoGainPan->Name = L"servoGainPan";
			this->servoGainPan->Size = System::Drawing::Size(46, 20);
			this->servoGainPan->TabIndex = 126;
			this->servoGainPan->Text = L"170";
			this->servoGainPan->TextChanged += gcnew System::EventHandler(this, &Form1::PanGainEdit_ValueChanged);
			// 
			// servoGainTilt
			// 
			this->servoGainTilt->Location = System::Drawing::Point(139, 127);
			this->servoGainTilt->Name = L"servoGainTilt";
			this->servoGainTilt->Size = System::Drawing::Size(46, 20);
			this->servoGainTilt->TabIndex = 125;
			this->servoGainTilt->Text = L"170";
			this->servoGainTilt->TextChanged += gcnew System::EventHandler(this, &Form1::TiltGainEdit_ValueChanged);
			// 
			// label42
			// 
			this->label42->AutoSize = true;
			this->label42->Location = System::Drawing::Point(53, 130);
			this->label42->Name = L"label42";
			this->label42->Size = System::Drawing::Size(29, 13);
			this->label42->TabIndex = 128;
			this->label42->Text = L"Gain";
			// 
			// inputPanCenter
			// 
			this->inputPanCenter->Location = System::Drawing::Point(87, 103);
			this->inputPanCenter->Name = L"inputPanCenter";
			this->inputPanCenter->Size = System::Drawing::Size(46, 20);
			this->inputPanCenter->TabIndex = 122;
			this->inputPanCenter->Text = L"1500";
			this->inputPanCenter->TextChanged += gcnew System::EventHandler(this, &Form1::PanCenterEdit_ValueChanged);
			// 
			// inputPanTravlMin
			// 
			this->inputPanTravlMin->Location = System::Drawing::Point(87, 58);
			this->inputPanTravlMin->Name = L"inputPanTravlMin";
			this->inputPanTravlMin->Size = System::Drawing::Size(46, 20);
			this->inputPanTravlMin->TabIndex = 121;
			this->inputPanTravlMin->Text = L"1050";
			this->inputPanTravlMin->TextChanged += gcnew System::EventHandler(this, &Form1::PanMinTravelEdit_ValueChanged);
			// 
			// lbl_servo_center
			// 
			this->lbl_servo_center->AutoSize = true;
			this->lbl_servo_center->Location = System::Drawing::Point(44, 106);
			this->lbl_servo_center->Name = L"lbl_servo_center";
			this->lbl_servo_center->Size = System::Drawing::Size(38, 13);
			this->lbl_servo_center->TabIndex = 114;
			this->lbl_servo_center->Text = L"Center";
			// 
			// lbl_servo_max
			// 
			this->lbl_servo_max->AutoSize = true;
			this->lbl_servo_max->Location = System::Drawing::Point(25, 61);
			this->lbl_servo_max->Name = L"lbl_servo_max";
			this->lbl_servo_max->Size = System::Drawing::Size(57, 13);
			this->lbl_servo_max->TabIndex = 113;
			this->lbl_servo_max->Text = L"Travel Min";
			// 
			// Pan_lbl
			// 
			this->Pan_lbl->AutoSize = true;
			this->Pan_lbl->Font = (gcnew System::Drawing::Font(L"Microsoft Sans Serif", 8.25F, System::Drawing::FontStyle::Bold, System::Drawing::GraphicsUnit::Point, 
				static_cast<System::Byte>(0)));
			this->Pan_lbl->Location = System::Drawing::Point(92, 12);
			this->Pan_lbl->Name = L"Pan_lbl";
			this->Pan_lbl->Size = System::Drawing::Size(29, 13);
			this->Pan_lbl->TabIndex = 133;
			this->Pan_lbl->Text = L"Pan";
			// 
			// inputPanTravlMax
			// 
			this->inputPanTravlMax->Location = System::Drawing::Point(87, 80);
			this->inputPanTravlMax->Name = L"inputPanTravlMax";
			this->inputPanTravlMax->Size = System::Drawing::Size(46, 20);
			this->inputPanTravlMax->TabIndex = 134;
			this->inputPanTravlMax->Text = L"2150";
			this->inputPanTravlMax->TextChanged += gcnew System::EventHandler(this, &Form1::PanMaxTravelEdit_ValueChanged);
			// 
			// label1
			// 
			this->label1->AutoSize = true;
			this->label1->Location = System::Drawing::Point(22, 83);
			this->label1->Name = L"label1";
			this->label1->Size = System::Drawing::Size(60, 13);
			this->label1->TabIndex = 135;
			this->label1->Text = L"Travel Max";
			// 
			// inputTiltCenter
			// 
			this->inputTiltCenter->Location = System::Drawing::Point(139, 103);
			this->inputTiltCenter->Name = L"inputTiltCenter";
			this->inputTiltCenter->Size = System::Drawing::Size(46, 20);
			this->inputTiltCenter->TabIndex = 139;
			this->inputTiltCenter->Text = L"1500";
			this->inputTiltCenter->TextChanged += gcnew System::EventHandler(this, &Form1::TiltCenterEdit_ValueChanged);
			// 
			// inputTiltTravlMin
			// 
			this->inputTiltTravlMin->Location = System::Drawing::Point(139, 58);
			this->inputTiltTravlMin->Name = L"inputTiltTravlMin";
			this->inputTiltTravlMin->Size = System::Drawing::Size(46, 20);
			this->inputTiltTravlMin->TabIndex = 138;
			this->inputTiltTravlMin->Text = L"1050";
			this->inputTiltTravlMin->TextChanged += gcnew System::EventHandler(this, &Form1::TiltMinTravelEdit_ValueChanged);
			// 
			// label3
			// 
			this->label3->AutoSize = true;
			this->label3->Font = (gcnew System::Drawing::Font(L"Microsoft Sans Serif", 8.25F, System::Drawing::FontStyle::Bold, System::Drawing::GraphicsUnit::Point, 
				static_cast<System::Byte>(0)));
			this->label3->Location = System::Drawing::Point(147, 12);
			this->label3->Name = L"label3";
			this->label3->Size = System::Drawing::Size(25, 13);
			this->label3->TabIndex = 140;
			this->label3->Text = L"Tilt";
			// 
			// inputTiltTravlMax
			// 
			this->inputTiltTravlMax->Location = System::Drawing::Point(139, 80);
			this->inputTiltTravlMax->Name = L"inputTiltTravlMax";
			this->inputTiltTravlMax->Size = System::Drawing::Size(46, 20);
			this->inputTiltTravlMax->TabIndex = 141;
			this->inputTiltTravlMax->Text = L"2150";
			this->inputTiltTravlMax->TextChanged += gcnew System::EventHandler(this, &Form1::TiltMaxTravelEdit_ValueChanged);
			// 
			// inputRollCenter
			// 
			this->inputRollCenter->Location = System::Drawing::Point(191, 103);
			this->inputRollCenter->Name = L"inputRollCenter";
			this->inputRollCenter->Size = System::Drawing::Size(46, 20);
			this->inputRollCenter->TabIndex = 146;
			this->inputRollCenter->Text = L"1500";
			this->inputRollCenter->TextChanged += gcnew System::EventHandler(this, &Form1::RollCenterEdit_ValueChanged);
			// 
			// inputRollTravlMin
			// 
			this->inputRollTravlMin->Location = System::Drawing::Point(191, 58);
			this->inputRollTravlMin->Name = L"inputRollTravlMin";
			this->inputRollTravlMin->Size = System::Drawing::Size(46, 20);
			this->inputRollTravlMin->TabIndex = 145;
			this->inputRollTravlMin->Text = L"1050";
			this->inputRollTravlMin->TextChanged += gcnew System::EventHandler(this, &Form1::RollMinTravelEdit_ValueChanged);
			// 
			// label7
			// 
			this->label7->AutoSize = true;
			this->label7->Font = (gcnew System::Drawing::Font(L"Microsoft Sans Serif", 8.25F, System::Drawing::FontStyle::Bold, System::Drawing::GraphicsUnit::Point, 
				static_cast<System::Byte>(0)));
			this->label7->Location = System::Drawing::Point(197, 12);
			this->label7->Name = L"label7";
			this->label7->Size = System::Drawing::Size(29, 13);
			this->label7->TabIndex = 147;
			this->label7->Text = L"Roll";
			// 
			// inputRollTravlMax
			// 
			this->inputRollTravlMax->Location = System::Drawing::Point(191, 80);
			this->inputRollTravlMax->Name = L"inputRollTravlMax";
			this->inputRollTravlMax->Size = System::Drawing::Size(46, 20);
			this->inputRollTravlMax->TabIndex = 148;
			this->inputRollTravlMax->Text = L"2150";
			this->inputRollTravlMax->TextChanged += gcnew System::EventHandler(this, &Form1::RollMaxTravelEdit_ValueChanged);
			// 
			// servoGainRoll
			// 
			this->servoGainRoll->Location = System::Drawing::Point(191, 127);
			this->servoGainRoll->Name = L"servoGainRoll";
			this->servoGainRoll->Size = System::Drawing::Size(46, 20);
			this->servoGainRoll->TabIndex = 150;
			this->servoGainRoll->Text = L"170";
			this->servoGainRoll->TextChanged += gcnew System::EventHandler(this, &Form1::RollGainEdit_ValueChanged);
			// 
			// inputPanCh
			// 
			this->inputPanCh->FormattingEnabled = true;
			this->inputPanCh->Items->AddRange(gcnew cli::array< System::Object^  >(13) {L"0", L"1", L"2", L"3", L"4", L"5", L"6", L"7", 
				L"8", L"9", L"10", L"11", L"12"});
			this->inputPanCh->Location = System::Drawing::Point(88, 34);
			this->inputPanCh->Name = L"inputPanCh";
			this->inputPanCh->Size = System::Drawing::Size(45, 21);
			this->inputPanCh->TabIndex = 3;
			this->inputPanCh->Text = L"7";
			// 
			// label2
			// 
			this->label2->AutoSize = true;
			this->label2->Location = System::Drawing::Point(35, 154);
			this->label2->Name = L"label2";
			this->label2->Size = System::Drawing::Size(47, 13);
			this->label2->TabIndex = 151;
			this->label2->Text = L"Reverse";
			// 
			// inputTiltCh
			// 
			this->inputTiltCh->FormattingEnabled = true;
			this->inputTiltCh->Items->AddRange(gcnew cli::array< System::Object^  >(13) {L"0", L"1", L"2", L"3", L"4", L"5", L"6", L"7", 
				L"8", L"9", L"10", L"11", L"12"});
			this->inputTiltCh->Location = System::Drawing::Point(139, 34);
			this->inputTiltCh->Name = L"inputTiltCh";
			this->inputTiltCh->Size = System::Drawing::Size(46, 21);
			this->inputTiltCh->TabIndex = 4;
			this->inputTiltCh->Text = L"8";
			// 
			// label4
			// 
			this->label4->AutoSize = true;
			this->label4->Location = System::Drawing::Point(36, 37);
			this->label4->Name = L"label4";
			this->label4->Size = System::Drawing::Size(46, 13);
			this->label4->TabIndex = 152;
			this->label4->Text = L"Channel";
			// 
			// inputRollCh
			// 
			this->inputRollCh->FormattingEnabled = true;
			this->inputRollCh->Items->AddRange(gcnew cli::array< System::Object^  >(13) {L"0", L"1", L"2", L"3", L"4", L"5", L"6", L"7", 
				L"8", L"9", L"10", L"11", L"12"});
			this->inputRollCh->Location = System::Drawing::Point(191, 34);
			this->inputRollCh->Name = L"inputRollCh";
			this->inputRollCh->Size = System::Drawing::Size(46, 21);
			this->inputRollCh->TabIndex = 5;
			this->inputRollCh->Text = L"6";
			// 
			// rollCenter
			// 
			this->rollCenter->BackColor = System::Drawing::Color::Transparent;
			this->rollCenter->Controls->Add(this->inputRollCh);
			this->rollCenter->Controls->Add(this->label4);
			this->rollCenter->Controls->Add(this->inputTiltCh);
			this->rollCenter->Controls->Add(this->label2);
			this->rollCenter->Controls->Add(this->inputPanCh);
			this->rollCenter->Controls->Add(this->servoGainRoll);
			this->rollCenter->Controls->Add(this->inputRollTravlMax);
			this->rollCenter->Controls->Add(this->label7);
			this->rollCenter->Controls->Add(this->inputRollTravlMin);
			this->rollCenter->Controls->Add(this->inputRollCenter);
			this->rollCenter->Controls->Add(this->inputTiltTravlMax);
			this->rollCenter->Controls->Add(this->label3);
			this->rollCenter->Controls->Add(this->inputTiltTravlMin);
			this->rollCenter->Controls->Add(this->inputTiltCenter);
			this->rollCenter->Controls->Add(this->label1);
			this->rollCenter->Controls->Add(this->inputPanTravlMax);
			this->rollCenter->Controls->Add(this->Pan_lbl);
			this->rollCenter->Controls->Add(this->lbl_servo_max);
			this->rollCenter->Controls->Add(this->lbl_servo_center);
			this->rollCenter->Controls->Add(this->inputPanTravlMin);
			this->rollCenter->Controls->Add(this->inputPanCenter);
			this->rollCenter->Controls->Add(this->label42);
			this->rollCenter->Controls->Add(this->servoGainTilt);
			this->rollCenter->Controls->Add(this->servoGainPan);
			this->rollCenter->Controls->Add(this->chk_pan);
			this->rollCenter->Controls->Add(this->chk_tilt);
			this->rollCenter->Controls->Add(this->chk_roll);
			this->rollCenter->Location = System::Drawing::Point(457, 214);
			this->rollCenter->Name = L"rollCenter";
			this->rollCenter->Size = System::Drawing::Size(260, 180);
			this->rollCenter->TabIndex = 133;
			this->rollCenter->TabStop = false;
			this->rollCenter->Text = L"Servo";
			// 
			// groupBox1
			// 
			this->groupBox1->Controls->Add(this->label6);
			this->groupBox1->Controls->Add(this->txtCh12);
			this->groupBox1->Controls->Add(this->txtCh11);
			this->groupBox1->Controls->Add(this->txtCh10);
			this->groupBox1->Controls->Add(this->txtCh9);
			this->groupBox1->Controls->Add(this->txtCh8);
			this->groupBox1->Controls->Add(this->txtCh7);
			this->groupBox1->Controls->Add(this->txtCh6);
			this->groupBox1->Controls->Add(this->txtCh5);
			this->groupBox1->Controls->Add(this->txtCh4);
			this->groupBox1->Controls->Add(this->txtCh3);
			this->groupBox1->Controls->Add(this->txtCh2);
			this->groupBox1->Controls->Add(this->txtCh1);
			this->groupBox1->Location = System::Drawing::Point(457, 395);
			this->groupBox1->Name = L"groupBox1";
			this->groupBox1->Size = System::Drawing::Size(260, 47);
			this->groupBox1->TabIndex = 140;
			this->groupBox1->TabStop = false;
			this->groupBox1->Text = L"Input Channel mappng";
			// 
			// label6
			// 
			this->label6->AutoSize = true;
			this->label6->Location = System::Drawing::Point(5, 22);
			this->label6->Name = L"label6";
			this->label6->Size = System::Drawing::Size(44, 13);
			this->label6->TabIndex = 12;
			this->label6->Text = L"Number";
			// 
			// txtCh12
			// 
			this->txtCh12->Location = System::Drawing::Point(233, 19);
			this->txtCh12->MaxLength = 2;
			this->txtCh12->Name = L"txtCh12";
			this->txtCh12->Size = System::Drawing::Size(18, 20);
			this->txtCh12->TabIndex = 11;
			this->txtCh12->Text = L"12";
			this->txtCh12->TextAlign = System::Windows::Forms::HorizontalAlignment::Right;
			this->txtCh12->TextChanged += gcnew System::EventHandler(this, &Form1::txtCh12_TextChanged);
			// 
			// txtCh11
			// 
			this->txtCh11->Location = System::Drawing::Point(217, 19);
			this->txtCh11->MaxLength = 2;
			this->txtCh11->Name = L"txtCh11";
			this->txtCh11->Size = System::Drawing::Size(18, 20);
			this->txtCh11->TabIndex = 10;
			this->txtCh11->Text = L"11";
			this->txtCh11->TextAlign = System::Windows::Forms::HorizontalAlignment::Right;
			this->txtCh11->TextChanged += gcnew System::EventHandler(this, &Form1::txtCh11_TextChanged);
			// 
			// txtCh10
			// 
			this->txtCh10->Location = System::Drawing::Point(201, 19);
			this->txtCh10->MaxLength = 2;
			this->txtCh10->Name = L"txtCh10";
			this->txtCh10->Size = System::Drawing::Size(18, 20);
			this->txtCh10->TabIndex = 9;
			this->txtCh10->Text = L"10";
			this->txtCh10->TextAlign = System::Windows::Forms::HorizontalAlignment::Right;
			this->txtCh10->TextChanged += gcnew System::EventHandler(this, &Form1::txtCh10_TextChanged);
			// 
			// txtCh9
			// 
			this->txtCh9->Location = System::Drawing::Point(185, 19);
			this->txtCh9->MaxLength = 2;
			this->txtCh9->Name = L"txtCh9";
			this->txtCh9->Size = System::Drawing::Size(18, 20);
			this->txtCh9->TabIndex = 8;
			this->txtCh9->Text = L"9";
			this->txtCh9->TextAlign = System::Windows::Forms::HorizontalAlignment::Right;
			this->txtCh9->TextChanged += gcnew System::EventHandler(this, &Form1::txtCh9_TextChanged);
			// 
			// txtCh8
			// 
			this->txtCh8->Location = System::Drawing::Point(166, 19);
			this->txtCh8->MaxLength = 2;
			this->txtCh8->Name = L"txtCh8";
			this->txtCh8->Size = System::Drawing::Size(18, 20);
			this->txtCh8->TabIndex = 7;
			this->txtCh8->Text = L"8";
			this->txtCh8->TextAlign = System::Windows::Forms::HorizontalAlignment::Right;
			this->txtCh8->TextChanged += gcnew System::EventHandler(this, &Form1::txtCh8_TextChanged);
			// 
			// txtCh7
			// 
			this->txtCh7->Location = System::Drawing::Point(150, 19);
			this->txtCh7->MaxLength = 2;
			this->txtCh7->Name = L"txtCh7";
			this->txtCh7->Size = System::Drawing::Size(18, 20);
			this->txtCh7->TabIndex = 6;
			this->txtCh7->Text = L"7";
			this->txtCh7->TextAlign = System::Windows::Forms::HorizontalAlignment::Right;
			this->txtCh7->TextChanged += gcnew System::EventHandler(this, &Form1::txtCh7_TextChanged);
			// 
			// txtCh6
			// 
			this->txtCh6->Location = System::Drawing::Point(134, 19);
			this->txtCh6->MaxLength = 2;
			this->txtCh6->Name = L"txtCh6";
			this->txtCh6->Size = System::Drawing::Size(18, 20);
			this->txtCh6->TabIndex = 5;
			this->txtCh6->Text = L"6";
			this->txtCh6->TextAlign = System::Windows::Forms::HorizontalAlignment::Right;
			this->txtCh6->TextChanged += gcnew System::EventHandler(this, &Form1::txtCh6_TextChanged);
			// 
			// txtCh5
			// 
			this->txtCh5->Location = System::Drawing::Point(118, 19);
			this->txtCh5->MaxLength = 2;
			this->txtCh5->Name = L"txtCh5";
			this->txtCh5->Size = System::Drawing::Size(18, 20);
			this->txtCh5->TabIndex = 4;
			this->txtCh5->Text = L"5";
			this->txtCh5->TextAlign = System::Windows::Forms::HorizontalAlignment::Right;
			this->txtCh5->TextChanged += gcnew System::EventHandler(this, &Form1::txtCh5_TextChanged);
			// 
			// txtCh4
			// 
			this->txtCh4->Location = System::Drawing::Point(98, 19);
			this->txtCh4->MaxLength = 2;
			this->txtCh4->Name = L"txtCh4";
			this->txtCh4->Size = System::Drawing::Size(18, 20);
			this->txtCh4->TabIndex = 3;
			this->txtCh4->Text = L"4";
			this->txtCh4->TextAlign = System::Windows::Forms::HorizontalAlignment::Right;
			this->txtCh4->TextChanged += gcnew System::EventHandler(this, &Form1::txtCh4_TextChanged);
			// 
			// txtCh3
			// 
			this->txtCh3->Location = System::Drawing::Point(82, 19);
			this->txtCh3->MaxLength = 2;
			this->txtCh3->Name = L"txtCh3";
			this->txtCh3->Size = System::Drawing::Size(18, 20);
			this->txtCh3->TabIndex = 2;
			this->txtCh3->Text = L"3";
			this->txtCh3->TextAlign = System::Windows::Forms::HorizontalAlignment::Right;
			this->txtCh3->TextChanged += gcnew System::EventHandler(this, &Form1::txtCh3_TextChanged);
			// 
			// txtCh2
			// 
			this->txtCh2->Location = System::Drawing::Point(66, 19);
			this->txtCh2->MaxLength = 2;
			this->txtCh2->Name = L"txtCh2";
			this->txtCh2->Size = System::Drawing::Size(18, 20);
			this->txtCh2->TabIndex = 1;
			this->txtCh2->Text = L"2";
			this->txtCh2->TextAlign = System::Windows::Forms::HorizontalAlignment::Right;
			this->txtCh2->TextChanged += gcnew System::EventHandler(this, &Form1::txtCh2_TextChanged);
			// 
			// txtCh1
			// 
			this->txtCh1->Location = System::Drawing::Point(50, 19);
			this->txtCh1->MaxLength = 2;
			this->txtCh1->Name = L"txtCh1";
			this->txtCh1->Size = System::Drawing::Size(18, 20);
			this->txtCh1->TabIndex = 0;
			this->txtCh1->Text = L"1";
			this->txtCh1->TextAlign = System::Windows::Forms::HorizontalAlignment::Right;
			this->txtCh1->TextChanged += gcnew System::EventHandler(this, &Form1::txtCh1_TextChanged);
			// 
			// tabControl1
			// 
			this->tabControl1->Controls->Add(this->tabPage2);
			this->tabControl1->Controls->Add(this->tabPage1);
			this->tabControl1->Location = System::Drawing::Point(4, 449);
			this->tabControl1->Name = L"tabControl1";
			this->tabControl1->SelectedIndex = 0;
			this->tabControl1->Size = System::Drawing::Size(788, 281);
			this->tabControl1->TabIndex = 141;
			// 
			// tabPage2
			// 
			this->tabPage2->Controls->Add(this->stop_HT);
			this->tabPage2->Controls->Add(this->clear_plot);
			this->tabPage2->Controls->Add(this->start_HT);
			this->tabPage2->Controls->Add(this->chart1);
			this->tabPage2->Location = System::Drawing::Point(4, 22);
			this->tabPage2->Name = L"tabPage2";
			this->tabPage2->Padding = System::Windows::Forms::Padding(3);
			this->tabPage2->Size = System::Drawing::Size(780, 255);
			this->tabPage2->TabIndex = 1;
			this->tabPage2->Text = L"Plot";
			this->tabPage2->UseVisualStyleBackColor = true;
			// 
			// stop_HT
			// 
			this->stop_HT->Enabled = false;
			this->stop_HT->Location = System::Drawing::Point(682, 108);
			this->stop_HT->Name = L"stop_HT";
			this->stop_HT->Size = System::Drawing::Size(75, 23);
			this->stop_HT->TabIndex = 126;
			this->stop_HT->Text = L"Stop plot";
			this->stop_HT->UseVisualStyleBackColor = true;
			this->stop_HT->Click += gcnew System::EventHandler(this, &Form1::stop_HT_Click);
			// 
			// clear_plot
			// 
			this->clear_plot->Location = System::Drawing::Point(682, 137);
			this->clear_plot->Name = L"clear_plot";
			this->clear_plot->Size = System::Drawing::Size(75, 23);
			this->clear_plot->TabIndex = 125;
			this->clear_plot->Text = L"Clear plot";
			this->clear_plot->UseVisualStyleBackColor = true;
			this->clear_plot->Click += gcnew System::EventHandler(this, &Form1::clear_plot_Click);
			// 
			// start_HT
			// 
			this->start_HT->Enabled = false;
			this->start_HT->Location = System::Drawing::Point(682, 79);
			this->start_HT->Name = L"start_HT";
			this->start_HT->Size = System::Drawing::Size(75, 23);
			this->start_HT->TabIndex = 124;
			this->start_HT->Text = L"Start plot";
			this->start_HT->UseVisualStyleBackColor = true;
			this->start_HT->Click += gcnew System::EventHandler(this, &Form1::start_HT_Click);
			// 
			// chart1
			// 
			this->chart1->BackColor = System::Drawing::Color::Transparent;
			chartArea3->BackColor = System::Drawing::Color::Transparent;
			chartArea3->BackImageTransparentColor = System::Drawing::Color::Red;
			chartArea3->BackSecondaryColor = System::Drawing::Color::Black;
			chartArea3->Name = L"ChartArea1";
			chartArea3->ShadowColor = System::Drawing::Color::Fuchsia;
			this->chart1->ChartAreas->Add(chartArea3);
			legend3->BackColor = System::Drawing::Color::Transparent;
			legend3->Name = L"Legend1";
			this->chart1->Legends->Add(legend3);
			this->chart1->Location = System::Drawing::Point(3, 3);
			this->chart1->Margin = System::Windows::Forms::Padding(0);
			this->chart1->Name = L"chart1";
			series7->ChartArea = L"ChartArea1";
			series7->ChartType = System::Windows::Forms::DataVisualization::Charting::SeriesChartType::Line;
			series7->Legend = L"Legend1";
			series7->Name = L"Pan";
			series8->ChartArea = L"ChartArea1";
			series8->ChartType = System::Windows::Forms::DataVisualization::Charting::SeriesChartType::Line;
			series8->Legend = L"Legend1";
			series8->Name = L"Tilt";
			series9->ChartArea = L"ChartArea1";
			series9->ChartType = System::Windows::Forms::DataVisualization::Charting::SeriesChartType::Line;
			series9->Legend = L"Legend1";
			series9->Name = L"Roll";
			this->chart1->Series->Add(series7);
			this->chart1->Series->Add(series8);
			this->chart1->Series->Add(series9);
			this->chart1->Size = System::Drawing::Size(760, 223);
			this->chart1->TabIndex = 79;
			this->chart1->Text = L"chart1";
			// 
			// tabPage1
			// 
			this->tabPage1->Controls->Add(this->picDraw);
			this->tabPage1->Location = System::Drawing::Point(4, 22);
			this->tabPage1->Name = L"tabPage1";
			this->tabPage1->Padding = System::Windows::Forms::Padding(3);
			this->tabPage1->Size = System::Drawing::Size(780, 255);
			this->tabPage1->TabIndex = 2;
			this->tabPage1->Text = L"View";
			this->tabPage1->UseVisualStyleBackColor = true;
			// 
			// picDraw
			// 
			this->picDraw->Location = System::Drawing::Point(8, 7);
			this->picDraw->Name = L"picDraw";
			this->picDraw->Size = System::Drawing::Size(378, 243);
			this->picDraw->TabIndex = 0;
			this->picDraw->TabStop = false;
			// 
			// Form1
			// 
			this->AutoScaleDimensions = System::Drawing::SizeF(6, 13);
			this->AutoScaleMode = System::Windows::Forms::AutoScaleMode::Font;
			this->BackColor = System::Drawing::Color::SkyBlue;
			this->ClientSize = System::Drawing::Size(792, 733);
			this->Controls->Add(this->tabControl1);
			this->Controls->Add(this->groupBox1);
			this->Controls->Add(this->grpBoxServp2);
			this->Controls->Add(this->btnCalibrate);
			this->Controls->Add(this->groupBox2);
			this->Controls->Add(this->rollCenter);
			this->Controls->Add(this->btn_update_headtracker);
			this->Controls->Add(this->Serial_output_box);
			this->Controls->Add(this->btn_disconnect);
			this->Controls->Add(this->btn_connect);
			this->Controls->Add(this->dd_comport);
			this->Controls->Add(this->menuStrip1);
			this->MainMenuStrip = this->menuStrip1;
			this->MaximizeBox = false;
			this->Name = L"Form1";
			this->SizeGripStyle = System::Windows::Forms::SizeGripStyle::Hide;
			this->Text = L"DIY Headtracker GUI v1.04  -  (Dennis Frie & Friends - 2012-2013)";
			this->Load += gcnew System::EventHandler(this, &Form1::Form1_Load);
			this->groupBox2->ResumeLayout(false);
			this->groupBox2->PerformLayout();
			this->grpBoxServp2->ResumeLayout(false);
			this->grpBoxServp2->PerformLayout();
			(cli::safe_cast<System::ComponentModel::ISupportInitialize^  >(this->rollGainTrackBar))->EndInit();
			(cli::safe_cast<System::ComponentModel::ISupportInitialize^  >(this->tiltGainTrackBar))->EndInit();
			(cli::safe_cast<System::ComponentModel::ISupportInitialize^  >(this->panGainTrackBar))->EndInit();
			(cli::safe_cast<System::ComponentModel::ISupportInitialize^  >(this->rollMaxTrackBar))->EndInit();
			(cli::safe_cast<System::ComponentModel::ISupportInitialize^  >(this->rollMinTrackBar))->EndInit();
			(cli::safe_cast<System::ComponentModel::ISupportInitialize^  >(this->rollCenterTrackBar))->EndInit();
			(cli::safe_cast<System::ComponentModel::ISupportInitialize^  >(this->tiltMaxTrackBar))->EndInit();
			(cli::safe_cast<System::ComponentModel::ISupportInitialize^  >(this->tiltMinTrackBar))->EndInit();
			(cli::safe_cast<System::ComponentModel::ISupportInitialize^  >(this->tiltCenterTrackBar))->EndInit();
			(cli::safe_cast<System::ComponentModel::ISupportInitialize^  >(this->panMaxTrackBar))->EndInit();
			(cli::safe_cast<System::ComponentModel::ISupportInitialize^  >(this->panMinTrackBar))->EndInit();
			(cli::safe_cast<System::ComponentModel::ISupportInitialize^  >(this->panCenterTrackBar))->EndInit();
			this->menuStrip1->ResumeLayout(false);
			this->menuStrip1->PerformLayout();
			this->rollCenter->ResumeLayout(false);
			this->rollCenter->PerformLayout();
			this->groupBox1->ResumeLayout(false);
			this->groupBox1->PerformLayout();
			this->tabControl1->ResumeLayout(false);
			this->tabPage2->ResumeLayout(false);
			(cli::safe_cast<System::ComponentModel::ISupportInitialize^  >(this->chart1))->EndInit();
			this->tabPage1->ResumeLayout(false);
			(cli::safe_cast<System::ComponentModel::ISupportInitialize^  >(this->picDraw))->EndInit();
			this->ResumeLayout(false);
			this->PerformLayout();

		}
#pragma endregion

private: // variables

    CalWizard^ _CalWizard;

	System::String^ rLine; // received line
	

private:
    System::Void Form1_Load(System::Object^  sender, System::EventArgs^  e);
    System::Void RetrieveSettings();
	System::Void onReady();
	System::Void Form1::ChannelChanged(System::Object^   sender, int id);
	System::Void Form1::lineReceived(System::String^ line);
    System::Void UpdateSettingsFromUI(HTSETTINGS& Settings);
    System::Void btn_connect_Click(System::Object^  sender, System::EventArgs^  e);
    System::Void btn_disconnect_Click(System::Object^  sender, System::EventArgs^  e);
    System::Void timer1_Tick(System::Object^  sender, System::EventArgs^  e);
    System::Void comPortTimer_Tick(System::Object^  sender, System::EventArgs^  e);
    System::Void start_HT_Click(System::Object^  sender, System::EventArgs^  e);
    System::Void clear_plot_Click(System::Object^  sender, System::EventArgs^  e);
    System::Void btn_update_headtracker_Click(System::Object^  sender, System::EventArgs^  e);
    System::Void stop_HT_Click(System::Object^  sender, System::EventArgs^  e);
    System::Void btnCalibrate_Click(System::Object^  sender, System::EventArgs^  e);
    System::Void exitToolStripMenuItem_Click(System::Object^  sender, System::EventArgs^  e);
    System::Void aboutToolStripMenuItem_Click(System::Object^  sender, System::EventArgs^  e);
    System::Void btnSendManualCmd_Click(System::Object^  sender, System::EventArgs^  e);
    System::Void PanCenterTrackBar_ValueChanged(System::Object^  sender, System::EventArgs^  e);
    System::Void PanMinTrackBar_ValueChanged(System::Object^  sender, System::EventArgs^  e);
    System::Void PanMaxTrackBar_ValueChanged(System::Object^  sender, System::EventArgs^  e);
    System::Void TiltCenterTrackBar_ValueChanged(System::Object^  sender, System::EventArgs^  e);
    System::Void TiltMinTrackBar_ValueChanged(System::Object^  sender, System::EventArgs^  e);
    System::Void TiltMaxTrackBar_ValueChanged(System::Object^  sender, System::EventArgs^  e);
    System::Void RollCenterTrackBar_ValueChanged(System::Object^  sender, System::EventArgs^  e);
    System::Void RollMinTrackBar_ValueChanged(System::Object^  sender, System::EventArgs^  e);
    System::Void RollMaxTrackBar_ValueChanged(System::Object^  sender, System::EventArgs^  e);
    System::Void PanGainTrackBar_ValueChanged(System::Object^  sender, System::EventArgs^  e);
    System::Void TiltGainTrackBar_ValueChanged(System::Object^  sender, System::EventArgs^  e);
    System::Void RollGainTrackBar_ValueChanged(System::Object^  sender, System::EventArgs^  e);
    System::Void PanMinTravelEdit_ValueChanged(System::Object^  sender, System::EventArgs^  e);
    System::Void PanMaxTravelEdit_ValueChanged(System::Object^  sender, System::EventArgs^  e);
    System::Void PanCenterEdit_ValueChanged(System::Object^  sender, System::EventArgs^  e);
    System::Void TiltMinTravelEdit_ValueChanged(System::Object^  sender, System::EventArgs^  e);
    System::Void TiltMaxTravelEdit_ValueChanged(System::Object^  sender, System::EventArgs^  e);
    System::Void TiltCenterEdit_ValueChanged(System::Object^  sender, System::EventArgs^  e);
    System::Void RollMinTravelEdit_ValueChanged(System::Object^  sender, System::EventArgs^  e);
    System::Void RollMaxTravelEdit_ValueChanged(System::Object^  sender, System::EventArgs^  e);
    System::Void RollCenterEdit_ValueChanged(System::Object^  sender, System::EventArgs^  e);
    System::Void TiltGainEdit_ValueChanged(System::Object^  sender, System::EventArgs^  e);
    System::Void PanGainEdit_ValueChanged(System::Object^  sender, System::EventArgs^  e);
    System::Void RollGainEdit_ValueChanged(System::Object^  sender, System::EventArgs^  e);
    System::Void OnCalWizard_Menu(System::Object^  sender, System::EventArgs^  e);
    System::Void OnCalWizardRot_Menu(System::Object^  sender, System::EventArgs^  e);
    System::Void OnExportSettingsToFile_Menu(System::Object^  sender, System::EventArgs^  e);
    System::Void OnImportSettingsFromFile_Menu(System::Object^  sender, System::EventArgs^  e);
    System::Void ManualCmdEdit_OnFocusEnter(System::Object^  sender, System::EventArgs^  e);
    System::Void ManualCmdEdit_OnKeyDown(System::Object^  sender, System::Windows::Forms::KeyEventArgs^  e);

private: System::Void txtCh1_TextChanged(System::Object^  sender, System::EventArgs^  e) {
			 ChannelChanged(sender,1);
		 }
private: System::Void txtCh2_TextChanged(System::Object^  sender, System::EventArgs^  e) {
			ChannelChanged(sender,2);
		 }
private: System::Void txtCh3_TextChanged(System::Object^  sender, System::EventArgs^  e) {
			 ChannelChanged(sender,3);
		 }
private: System::Void txtCh4_TextChanged(System::Object^  sender, System::EventArgs^  e) {
			 ChannelChanged(sender,4);
		 }
private: System::Void txtCh5_TextChanged(System::Object^  sender, System::EventArgs^  e) {
			 ChannelChanged(sender,5);
		 }
private: System::Void txtCh11_TextChanged(System::Object^  sender, System::EventArgs^  e) {
			 ChannelChanged(sender,11);
		 }
private: System::Void txtCh10_TextChanged(System::Object^  sender, System::EventArgs^  e) {
			 ChannelChanged(sender,10);
		 }
private: System::Void txtCh9_TextChanged(System::Object^  sender, System::EventArgs^  e) {
			 ChannelChanged(sender,9);
		 }
private: System::Void txtCh8_TextChanged(System::Object^  sender, System::EventArgs^  e) {
			 ChannelChanged(sender,8);
		 }
private: System::Void txtCh7_TextChanged(System::Object^  sender, System::EventArgs^  e) {
			 ChannelChanged(sender,7);
		 }
private: System::Void txtCh6_TextChanged(System::Object^  sender, System::EventArgs^  e) {
			 ChannelChanged(sender,6);
		 }
private: System::Void txtCh12_TextChanged(System::Object^  sender, System::EventArgs^  e) {
			 ChannelChanged(sender,12);
		 }
private: System::Void tabPage1_Click(System::Object^  sender, System::EventArgs^  e) {
		 }

private: System::Void lbl_gyro_weight_pan_Click(System::Object^  sender, System::EventArgs^  e) {
		 }
}; // class



} // namespace
