night-ghost/open-headtracker/(commit log)

2015-07-15 all founded forks of original DIY_Headtracker ( DIY_Headtracker_firmware_orig )
    DIY_Headtracker_firmware_fastserial - changed to FastSerial library with printf_P, uses ATAN2 (no more NAN!) and some cleanup
    DIY_Headtracker_firmware - changed filter to Madgwick AHRS (http://www.x-io.co.uk/node/8#open_source_ahrs_and_imu_algorithms)
    DIY_headtracker-8mhz - port to 8mhz Arduino
    and others for different sensors
2015-07-31 lot of efforts for MadgwicjAHRS version
    rework of FastSerial version
    [DIY_headtracker.ino, FourtOrderFilter.h, Functions.cpp, Sensors.cpp, config.h, eeprom.h, functions.h, sensors.h]
2015-07-31 rework of GUI - no more "firmware version: unknown" - reset on connect with wait of finish of initialization - changed logick of min-center-max PPM parameters - added debug output
    [AccelCalibrate.cpp, AssemblyInfo.cpp, CalWizard.cpp, HeadTrackerHardware.h, MagCalibrate.cpp, MainForm.cpp, MainForm.h, stdafx.cpp]
2017-06-09 * sensor timer moved from timer0 to timer2 - so we can use millis()! * odd slow Wire library changed to fast I2C library * I2C library altered to speed up and reduce size * added full compass calibra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
    [DIY headtracker layout.lay, DIY headtracker layout.lay6]
