night-ghost/open-headtracker/(notices)

Notices in the files:
Source Code/HeadTracker_GUI/AP_GeodesicGrid.h:
under the terms of the GNU General Public License as published by the
Free Software Foundation, either version 3 of the License, or
(at your option) any later version.
Source Code/DIY_Headtracker_Firmware_fastserial/DIY_headtracker/FourtOrderFilter.h:
This program is free software: you can redistribute it and/or modify
it under the terms of the GNU General Public License as published by
the Free Software Foundation, either version 3 of the License, or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
